roadtothewest/SSI/archivo/docs/refactor-emg-software.md

# Refactor de software a sEMG

**Estado:** especificación activa. Define la fuente sEMG de 4 canales en
todo el árbol de software del proyecto SSI (firmware, `ssr-ingest`, `export.py`,
arquitectura de modelo, HMI).

**Fecha:** septiembre 2026. Contexto: Muestra TECH 2026, 15 de octubre.

**Relación con otros documentos:**

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

---

## 0. Mantra del proyecto (principio rector)

Todo lo que sigue existe para cumplir **dos objetivos simultáneos, no uno**:

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

---

## 1. Decisiones ya cerradas (no reabrir)

| Decisión | Valor | Fuente |
|---|---|---|
| Sensor primario | sEMG diferencial, **4 canales** (submentoniano, platisma, labio inferior, laringe) + RLD | `AFE_EMG_Diseno.md` |
| AFE | Construcción propia (discreto, 4 canales), no comprar AFE comercial armado; HackEEG/ADS129x evaluados y descartados por no-disponibilidad (no por mérito técnico) | `AFE_EMG_Diseno.md` §1, §3-4; ver también §7.3 de este doc |
| Micrófono | **Digital I2S — INMP441**, candidato recomendado, **NO comprado aún** | `bom.csv`; investigación previa a la compra en §2 de este doc |
| Entrada auxiliar analógica de mic vía ADS129x | Descartada, no aplica (no se usa ADS129x) | Indicación explícita del usuario |
| Arquitectura de modelo (Conv2D paralelo por canal → TCN causal → vocoder WORLD) | Se mantiene sin cambios de topología | `sprints/sprint-1/DL.md`, `clave.md` — el pipeline es agnóstico al tipo de sensor, solo cambia la semántica de los 4 canales de entrada |

---

## 2. Micrófono digital: investigación previa a la compra

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

**Evidencia encontrada (calidad de audio real, no solo hoja de datos):**

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

---

## 3. Metodología de causalidad — esto define el éxito del proyecto

Esta es la sección más importante del refactor. Medir sEMG no vale nada si el
software solo reporta una correlación de Pearson. El argumento nuevo del proyecto es que el sEMG es
la **causa** (activación neuromuscular), anterior en el tiempo al sonido — y
esa anterioridad tiene que ser medible.

### 3.1 Lo que no basta

Un coeficiente de correlación entre sEMG y voz demuestra correlación, no
causalidad.

### 3.2 Lo que sí sostiene la afirmación

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

### 3.3 Confusor crítico: el canal laríngeo (CH4)

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

Controles obligatorios del protocolo de captura:

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

### 3.4 Protocolo de diagnóstico por canal (piso de ruido es una lectura, no el objetivo)

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

---

## 4. Esquema de datos y transporte

- **Requisito nuevo del esquema de tupla:** cada tupla del corpus debe llevar
  el lag medido (o los datos crudos suficientes para recalcularlo). Sin eso,
  el dataset solo sostiene correlación, no causalidad — es el mismo problema
  del punto 3.1 pero a nivel de formato de archivo, no de análisis.
- El frame EMG (tipo `0x03`, definido en `AFE_EMG_Diseno.md` §5.1) es la
  fuente de la CWT. El frame AUDIO (`0x02`, del INMP441) no cambia.
- El servicio Go (`ssr-ingest`) no debe caerse ante desconexiones del AFE.

---

## 5. Corrección de un supuesto del plan original: ventana vs. hop de la CWT

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

---

## 6. Checklist de refactor de software (archivo por archivo)

**Firmware (`ssr-testbed/firmware/`)**

- [x] Driver del sensor anterior eliminado (`main.c`, `frame.c`, `Makefile`,
      `usb_cdc.h`), 27-sep.
- [ ] `Core/Src/frame.c`: agregar `frame_process_emg_*`, leyendo 4 canales
      desde ADC+DMA, con `CDC_TYPE_EMG` (`0x03`). En `main.c` hay un
      comentario en el lazo principal donde va la llamada.
- [ ] Bug previo: `frame.c` usa `active_buf`, que es `static` en
      `inmp441.c` (no compila); y `inmp441.c` registra los callbacks de TX de
      I2S (`HAL_I2S_TxHalfCpltCallback`) en vez de los de RX.
- [ ] `Core/Src/sync_timer.c`: se reutiliza sin cambios (la base de tiempo
      común es agnóstica al sensor).

**PC — ingesta (`ssr-testbed/pc-tools/ssr-ingest/`, Go)**

- [x] Parser (`parser/frame.go`), `ssr-inspect` y `ssr-replay`: reconocen el
      frame `0x03` (27-sep).
- [ ] `storage/writer.go`: agregar el sensor EMG a `metadata.json` y su
      contador de frames. Además no compila por errores previos
      (`sha256.Sum256` usado como tipo, `WriteFrame` declarado dos veces).

**PC — exportación (`ssr-testbed/pc-tools/ssr-export/export.py`)**

- [x] `extract_emg_channels`: 4 canales int16 intercalados, timestamps con la
      tasa real del ADC (`--fs-emg`, 2 kHz por defecto); CWT de 20–500 Hz por
      canal, salida `cwt_mag` (4, escalas, N). Probado con un `.ssr`
      sintético (27-sep).
- [x] `align_channels`: alinea EMG y audio por timestamp.
- [ ] CWT: separar parámetro `window_ms` (≥50–100 ms) de `hop_ms` (5/10/20 ms)
      — ver §5 de este documento.
- [ ] Agregar el cálculo de correlación cruzada con lag (§3.2) como parte del
      pipeline de exportación, no como notebook aparte.

**Round-trip de audio (`ssr-testbed/pc-tools/ssr-roundtrip/`)**

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

**Documentación del testbed (`ssr-testbed/docs/`)**

- [x] `architecture.md`, `pinout.md`, `pipeline.md` y diagramas describen la
      fuente sEMG (27-sep). Los pines del ADC siguen **bloqueados por una
      decisión pendiente** — ver TODO 7.1 más abajo.

**Modelo (`sprints/sprint-1/DL.md`, `clave.md`)**

- [x] Adaptados a 4 canales sEMG (submentoniano, platisma, labio inferior,
      laringe): ramas Conv2D paralelas por canal y TCN causal (27-sep).

**HMI**

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

---

## 7. Preguntas abiertas (genuinas — no decidir por defecto)

### 7.1 MCU objetivo del testbed — **inconsistencia detectada, requiere decisión del usuario**

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

### 7.2 Resolución de ADC y ganancia total

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

### 7.3 Mínimo de canales para la demo — **CERRADO EN 4**

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

**No se vuelve a reabrir esta pregunta** salvo cambio de presupuesto o de
disponibilidad de componentes.

### 7.4 Tipo de inferencia del modelo

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

---

## 8. Especificación de HMI multi-pestaña

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

## 9. Verificación de bi-direccionalidad del vocoder WORLD

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

## 10. Referencias

- `docs/afe-emg/AFE_EMG_Diseno.md` — diseño de hardware del AFE sEMG (4 canales).
- [ESP32 Audio Input - INMP441 and SPH0645 MEMS I2S Breakout Boards (atomic14, YouTube)](https://www.youtube.com/watch?v=3g7l5bm7fZ8)
- [ICS-43434, a replacement for the old INMP441 (atomic14)](https://www.atomic14.com/videos/posts/VVGln_-XEgI)
- `bom.csv` — estado de compra de componentes (INMP441 candidato, pendiente de compra; AFE sEMG de 4 canales cotizado — ver §7.3).
- [BioAmp EXG Pill — Crowd Supply](https://www.crowdsupply.com/upside-down-labs/bioamp-exg-pill) — pricing consultado sep. 2026: USD 35–249 según pack, sin RLD onboard.
- [HackEEG — Crowd Supply](https://www.crowdsupply.com/starcat/hackeeg) — USD 495–2090, descontinuado (sin stock) al consultar sep. 2026.
- `ssr-testbed/pc-tools/ssr-roundtrip/` — prototipo de round-trip de audio (Mel+Griffin-Lim, pendiente extender a WORLD — ver §9).
- `sprints/sprint-1/clave.md` — comparación Mel+Griffin-Lim vs. vocoder WORLD, recomienda WORLD.
