roadtothewest/SSI/archivo/sprints/sprint-1/gpt-ups-pelao.md

Puedes lograr un diseño compacto usando componentes miniaturizados.
## Alternativas de tamaño reducido

* La Batería (UPS): En lugar de celdas cilíndricas 18650, usa una batería de Polímero de Litio (LiPo) plana. Una de 1000 mAh a 2000 mAh tiene el grosor de un teléfono móvil y se puede colocar directamente debajo de la Radxa.
* La Placa de Control (UPS): Existen módulos de carga y elevación de voltaje (como el chip IP5306 o similares) en circuitos de apenas 2 cm × 2 cm que entregan 5V/2A o 3A con soporte "pass-through".
* El Parlante: Los parlantes piezoeléctricos o los altavoces de tipo "móvil/laptop" (de 1W o 2W) miden pocos milímetros de grosor y consumen muy poca corriente.

Si apilas la batería LiPo, la Radxa y la pequeña placa UPS, el grosor total del dispositivo podría ser menor a 2.5 centímetros, manteniendo la misma superficie pequeña de la Radxa Zero (6.5 cm × 3 cm).
Para ayudarte a optimizar el espacio, cuéntame:

* ¿Cuánto tiempo de autonomía de batería necesitas que tenga el dispositivo sin estar enchufado?
* ¿El parlante es para reproducir alertas/pitidos cortos o para reproducir voz/música continua?
