roadtothewest/SSI/docs/afe-emg/BoM_AFE_AuraVox_compacta.pdf

BoM compacta AFE sEMG AuraVox (3 canales, incluye repuesto). Detalle por modulo en BoM_AFE_AuraVox.xlsx

Valor / parte | Cantidad | Componente
SOIC8 a DIP8 | 7 Adaptador SOIC-8 a DIP-8
SOT23 a DIP | 2 Adaptador SOT-23-5 a DIP
Alcohol isopropilico / gel | 1 Alcohol isopropilico / gel
jumper Dupont | 3 Cable 5 V y GND desde el DK
jumper Dupont | 5 Cable a Arduino A1..A3 del STM32N6570-DK
broche 4 mm a pin | 8 Cable de electrodo con broche (snap) 4 mm, idealmente apantal
24 AWG rigido | 1 Cable para puentes
jumper Dupont | 6 Cables Dupont para el microfono
header 2.54 mm 1x8 + hembra | 2 Conector en la placa para los 7 cables
3M Red Dot 2228/2560 | 50 Electrodo Ag/AgCl con broche
INA333 modulo MCU-333 | 4 INA333 (modulo MCU-333)
INMP441 | 2 Modulo microfono digital INMP441 (I2S)
TS922AIYDT | 6 Op-amp doble TS922AIYDT (Global 001-TS922)
10 x 15 cm | 2 Perfboard
TLV75733PDBVR | 2 Regulador LDO 3.3 V TLV75733PDBVR (Global 014-75733)
2.54 mm | 3 Tira de headers macho/hembra
DIP-8 | 7 Zocalo DIP-8
100p | 4 cond. ceramico C0G
1n | 10 cond. ceramico C0G
47p | 8 cond. ceramico C0G
100n | 12 cond. ceramico/electrolitico
10u | 7 cond. ceramico/electrolitico
1u | 3 cond. ceramico/electrolitico
100n | 8 cond. poliester (film)
150n | 4 cond. poliester o C0G
15n | 4 cond. poliester o C0G
2.2n | 4 cond. poliester o C0G
1N4148 | 16 diodo
100 | 4 resistencia
100k | 10 resistencia
10M | 2 resistencia
110k | 4 resistencia
1k | 8 resistencia
2.2k | 4 resistencia
2.4k | 4 resistencia
2.7k | 10 resistencia
300k | 4 resistencia
390k | 2 resistencia
56k | 12 resistencia
620k | 4 resistencia

Precio unit. (CLP) | Subtotal (CLP) | Comprado
TOTAL | -
