roadtothewest/SSI/archivo/sprints/sprint-1/clave.md

El uso de la NPU de la STM32N6 cambia las reglas del juego a tu favor, ya que te permite manejar un volumen de operaciones mucho mayor, pero las restricciones de memoria y operadores soportados son estrictas.
Aquí tienes cómo resolver los cuellos de botella de la NPU y la mejor alternativa matemática para tu algoritmo bi-direccional.
Resolviendo las restricciones de la NPU (STM32N6)
BatchNormalization (El truco del "Folding"): No te preocupes por la falta de soporte para BN en la NPU. Durante la conversión del modelo (cuando pasas de TensorFlow/ONNX a C mediante X-CUBE-AI), el compilador aplica una optimización estándar llamada Conv-BN Folding. La matemática de la normalización (medias y varianzas) se absorbe permanentemente en los pesos y sesgos de la capa Conv1D/Conv2D anterior. En tiempo de ejecución, la capa de Batch Normalization literalmente no existe; la NPU solo ejecuta la convolución modificada.
Cero Transpose: Para evitar operaciones de transposición de tensores, tu modelo debe mantener una estructura estricta de Channels-Last (Batch, Time, Features). El peligro de generar un Transpose oculto ocurre al pasar de la etapa 1 (CNN 2D) a la etapa 2 (TCN 1D). Para evitarlo, no uses capas que permuten dimensiones; usa un simple Reshape que fusione el eje de canales y el eje de frecuencias de la CWT, manteniendo el eje temporal exactamente en la misma posición geométrica en la memoria.
Activaciones de salida en CPU: Tienes toda la razón. Si Sigmoid o Tanh no están soportadas por la NPU, forzarán una ruptura del grafo (CPU fallback). La solución para mantener 0 SW layers es dejar la última capa Densa con activación Linear (es decir, sin función de activación). La NPU entregará las predicciones numéricas crudas, y tú aplicas el recorte o normalización matemáticamente en tu código C en el procesador principal de la STM32N6 antes de enviarlo al algoritmo generador de voz.
El Algoritmo Determinista Bi-direccional
Para que tu sistema sea viable, necesitas extraer "tokens" (vectores de características) del audio real para entrenar el modelo, y luego usar esos mismos vectores (ahora predichos por tu modelo desde las señales sEMG) para generar voz.
Dado que tu objetivo es voz humana para personas afónicas y exiges un algoritmo determinista (descartando vocoders neuronales pesados como HiFi-GAN que requieren otra red neuronal), tienes dos caminos principales.
El claro ganador para fidelidad de voz es el Vocoder WORLD.


Característica
Mel-Spectrogram + Griffin-Lim
Vocoder WORLD (o STRAIGHT)
Bi-direccionalidad
Alta (STFT de ida, Griffin-Lim de vuelta)
Perfecta (Análisis y Síntesis paramétrica)
Naturaleza de los "Tokens"
Bandas de energía espectral (ej. 80 coeficientes Mel)
$F_0$ (Pitch), Envolvente Espectral (Formantes), y Aperiodicidad
Fidelidad de la Voz
Robótica/Metálica (por los errores de estimación de fase)
Alta (Conserva la identidad vocal y la naturalidad del habla)
Determinista
Sí (Matemática pura)
Sí (Matemática pura)
Carga Computacional (Síntesis)
Media
Media-Alta (Ideal para la PC/Raspberry que mencionaste)
¿Por qué WORLD es el estándar para esto?
WORLD funciona separando la voz en sus componentes físicos fundamentales:
Análisis (Creación del Dataset): Pasas tus grabaciones de micrófono por WORLD. El algoritmo extrae el $F_0$ (la vibración de las cuerdas vocales), la Envolvente Espectral (cómo se posiciona la boca/lengua) y la Aperiodicidad (ruido/aire). Estos arreglos numéricos son los "tokens" o targets que tu modelo aprenderá a predecir.
Síntesis (Inferencia en vivo): Tu STM32N6 escupe estos tres arreglos predichos y los envía a la Raspberry o PC. El sintetizador de WORLD toma estos parámetros y los combina matemáticamente usando filtros digitales para generar el archivo .wav de salida.
%%%%%%%%%%%%%%%
El desarrollo de una interfaz de habla silenciosa (Silent Speech Interface) basada en sEMG es un excelente caso de uso para Edge AI. Inferir parámetros acústicos a partir de la actividad eléctrica de los músculos del habla requiere un modelo capaz de extraer tanto patrones frecuenciales instantáneos como dependencias temporales largas.
Para garantizar que el modelo final se despliegue en tu STM32 con 0 capas de software (sin CPU fallbacks), la clave es construir toda la arquitectura utilizando exclusivamente operadores matemáticos estándar soportados nativamente por optimizadores como X-CUBE-AI (por ejemplo, convoluciones, activaciones estándar, pooling y capas densas).
Aquí tienes una recomendación de arquitectura optimizada para este flujo:
Etapa 1: Extracción de Características (CNN en paralelo)
Dado que tu entrada es un espectrograma generado por la CWT (Tiempo $\times$ Escalas $\times$ 4 canales sEMG), esta etapa debe tratar la entrada casi como una imagen, pero respetando el eje temporal.
Arquitectura recomendada: Bloques de Depthwise Separable Convolutions (Conv2D).
Diseño: Divide la entrada en sub-ventanas temporales. En lugar de usar convoluciones 2D estándar (que consumen mucha memoria y ciclos de reloj), usa convoluciones separables. Esto aplica un filtro por cada canal (canal sEMG) y luego combina los resultados.
Paralelismo: Puedes tener cuatro ramas de CNN paralelas, una por canal sEMG (submentoniano, platisma, labio inferior, laringe), para extraer la firma de cada músculo de forma independiente, concatenando los mapas de características al final de esta etapa.
Compatibilidad: X-CUBE-AI soporta DepthwiseConv2D y SeparableConv2D de forma muy eficiente, acelerando el proceso mediante las instrucciones DSP del microcontrolador.
Etapa 2: Modelado Temporal (TCN)
Una Temporal Convolutional Network (TCN) es la elección perfecta para Edge AI, superando a las redes recurrentes (como LSTM o GRU). Las TCNs no tienen estados ocultos que mantener en memoria, se paralelizan mejor en inferencia y evitan operaciones no estándar.
Arquitectura recomendada: Capas de Dilated 1D Convolutions.
Diseño: La salida de la Etapa 1 se aplana en el eje de las frecuencias/escalas, quedando como un tensor de (Tiempo $\times$ Características). Pasas esto por una serie de Conv1D causales con factores de dilatación exponenciales ($d = 1, 2, 4, 8$).
Ventaja: Esto le da al modelo un "campo receptivo" muy amplio (necesario para entender fonemas largos o palabras enteras) sin aumentar la profundidad de la red a niveles incompatibles con la RAM del microcontrolador.
Compatibilidad: Para mantener los 0 SW layers, asegúrate de implementar la TCN utilizando estrictamente Conv1D estándar y BatchNormalization. Evita usar implementaciones de TCN de terceros que incluyan operaciones personalizadas de padding o slicing que el generador de código de la STM32 no reconozca.
Etapa 3: Proyección Acústica (Regresión)
Esta es la etapa de salida que conecta el modelo temporal con tu algoritmo determinista (Vocoder).
Arquitectura recomendada: Capas Densas (Fully Connected) o una Conv1D de tamaño de kernel 1.
Diseño: Esta etapa mapea la representación abstracta del TCN a los parámetros acústicos exactos que necesita tu sintetizador. Si usas un vocoder clásico (como WORLD o LPC), el modelo no debe generar el audio directamente, sino predecir los parámetros (Frecuencia fundamental $F_0$, envolvente espectral, aperiodicidad).
Función de activación: Linear o Sigmoid/Tanh dependiendo de cómo normalices los parámetros del vocoder.
Recomendaciones críticas para el Dataset y el Hardware
Sincronización de reloj (El mayor desafío): Al parear los datos RAW del ADC sEMG y el audio RAW del micrófono, la sincronización es vital. Los relojes del micrófono (I2S) y del muestreo del ADC derivarán ligeramente. Utiliza interrupciones de hardware en la STM32 (por ejemplo, la de fin de transferencia DMA del ADC) acopladas a marcas de tiempo (timestamps) de alta precisión para etiquetar tanto el audio como el sEMG.
CWT en el Microcontrolador vs PC: Calcular la CWT en el micro durante la recolección es una gran idea para probar el rendimiento, pero guarda también los datos RAW del sEMG en tu dataset. Las matemáticas de punto flotante de la librería CWT en la STM32 (Float32 o Fixed-Point) tendrán ligeras diferencias con la CWT calculada en Python. Durante el entrenamiento, necesitarás simular el ruido y la pérdida de precisión exacta que genera el cálculo en el micro.
Restricciones de activación: Para garantizar que el grafo de TensorFlow/Keras se traduzca limpiamente a C, usa exclusivamente activaciones ReLU. Funciona perfectamente para procesamiento de voz y está altamente optimizada en CMSIS-NN.

----

https://huggingface.co/spaces/STMicroelectronics/stm32-modelzoo-app

https://huggingface.co/STMicroelectronics/models

https://github.com/STMicroelectronics/stm32ai-modelzoo-services

https://github.com/STMicroelectronics/stm32ai-modelzoo/tree/main/speech_enhancement/stft_tcnn
