roadtothewest/SSI/archivo/sprints/sprint-1/DL.md

Estás muy cerca de la arquitectura ideal, pero la lógica estructural tiene un detalle crucial con respecto a la dimensionalidad de tu entrada.

La secuencia de **"Extracción paralela $\rightarrow$ Modelado Temporal"** es el enfoque correcto, pero en tu primera etapa **no deberías usar Conv1D, sino Conv2D**.

Al procesar los datos a través de una Transformada Wavelet Continua (CWT), cada señal sEMG unidimensional se convierte en un mapa bidimensional (un escalograma). Dado que tu pipeline extrae 64 escalas logarítmicas (de 20 a 500 Hz, la banda del AFE), tu red neuronal debe tratar esta entrada como si fuera una "imagen" para poder reconocer patrones geométricos en las frecuencias.

Aquí tienes la topología exacta de cómo deben fluir los tensores a través de la NPU de tu STM32N6:

### Etapa 1: Extracción Espacial en Paralelo (Conv2D)

En lugar de procesar los 4 canales sEMG mezclados desde el inicio, usar ramas paralelas permite que la red aprenda la firma mioeléctrica independiente de cada músculo.

1. **Entrada:** Cuatro tensores separados, uno por canal sEMG. Cada tensor tiene una forma dimensional de $T \times 64 \times 1$ (donde $T$ son los pasos de tiempo de tu ventana y 64 son las escalas de la CWT).

2. **Ramas Paralelas (Conv2D):** Cada canal pasa por su propia torre de convoluciones 2D.
* *Tip de Hardware:* Para no desbordar la SRAM de la STM32N6, utiliza *Depthwise Separable Convolutions 2D*. Estas extraen patrones de texturas frecuenciales y reducen los requerimientos computacionales drásticamente.

3. **Fusión (Concatenación):** Al final de las torres 2D, concatenas los mapas de características resultantes de los 4 canales en un solo tensor.

### Etapa 2: El "Pegamento" (Reshape)

Para conectar el mundo de las imágenes (Conv2D) con el mundo de las series de tiempo (TCN), necesitas transformar la dimensionalidad.

* **Operación:** Colapsas (aplanan) el eje de las frecuencias resultantes y el eje de los canales, preservando estrictamente el eje temporal.
* **Resultado:** Pasas de un tensor tridimensional a uno bidimensional: $T \times \text{Características}$. Este vector ya no representa frecuencias aisladas, sino un "resumen abstracto" de la actividad muscular en cada instante $T$.

### Etapa 3: Modelado Temporal (TCN con Conv1D)

Aquí es donde entran las **Conv1D**. Ahora que tienes un vector de características sólido para cada instante de tiempo, la Temporal Convolutional Network (TCN) se encarga de entender el contexto a largo plazo (cómo la activación muscular de hace 15 milisegundos afecta el sonido actual).

* **Bloques Causales:** Utilizarás capas **Conv1D** con *dilataciones causales* (donde el factor de dilatación aumenta exponencialmente, ej. $d = 1, 2, 4, 8$). Esto permite que la red tenga un "campo receptivo" altísimo, observando toda la ventana de tiempo simultáneamente sin necesidad de recurrencia.
* **Salida (Regresión):** La última capa será una Densa (Totalmente Conectada) con activación lineal que mapeará estas características temporales hacia los valores exactos (tokens) que necesita tu vocoder WORLD ($F_0$, Envolvente Espectral, y Aperiodicidad).

---

Considerando que aplicarás convoluciones bidimensionales sobre 64 escalas logarítmicas, ¿has definido qué factor de dilatación máximo ($d=2, 4, 8, 16...$) planeas usar en las capas Conv1D de la TCN para cubrir el campo receptivo de un fonema completo sin sobrepasar el límite de memoria estática de la NPU?
