roadtothewest/SSI/docs/AuraVox.pdf

## AuraVox

Estacion de Auditor ´ | ía – Corpus Generator

Matías Perez, Vicente Andrade ´

| Septiembre 2026

## 1. Arquitectura

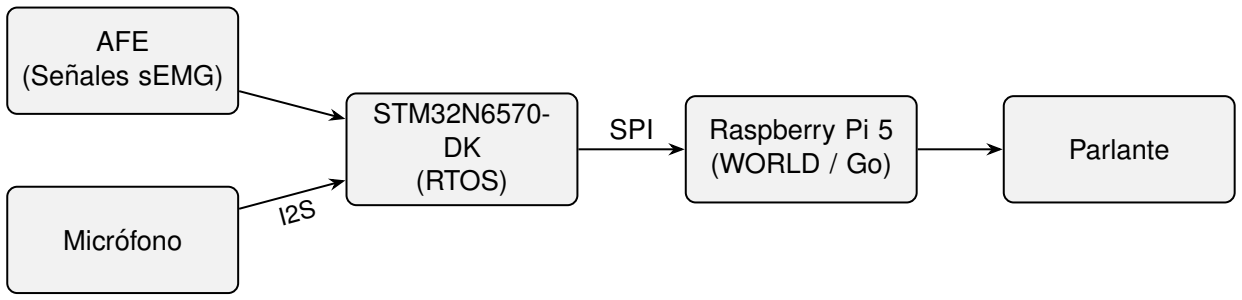
[picture p1: figure]
AFE (Senales sEMG) ˜; Microfono ´; STM32N6570- DK (RTOS); Raspberry Pi 5; (WORLD / Go); Parlante; SPI

## 2. Objetivos Específicos

Obtener correlacion y causalidad voz ´ | | ↔ sEMG: Demostrar la causalidad empírica-
mente: de la energía espectral neuromuscular pura hacia los fonemas.

Medir ”Piso Ruido” (baseline del stream espectral que alimenta al pipeline):

- Condiciones de evaluacion: AFE apagado, AFE encendido, y usuario callado. ´
- Caracterizar lecturas y diferenciar el stream sEMG con voz versus el stream con silencio.
- Resolver: ¿Es puro ruido o contiene informacion´ util para el modelo? ´

HMI: Monitoreo Benchmark de Procesamiento:

- Definir metricas y gr ´ | aficos para validar el proceso de causalidad. ´
- Comparar el calculo de ventanas CWT ( ´ | | cwt-win) entre la N6 y la Raspberry Pi.
- Probar barridos de ventanas de distinta duracion (5ms, 10ms, 20ms, etc.). ´
- Extraccion de features del Micr ´ | ofono: Envolvente, ´ | F0, Paratemporalidad, Magnitud y
Tono.

Orquestacion del Minimum Viable Dataset: ´

- Ingesta de paquetes: AFE → Microfono ´ → Time Stamp → Miscelaneos (ventanas ´ CWT, etc.).
- Conformacion del Dataset: Tuplas CWT-Vector (con correlaci ´ | | on real demostrada). ´

## 3. Plan de Ataque: El Sprint de 30 Días

Dado que tienes exactamente un mes, la clave para ganar no es implementar mas carac- ´ terísticas, sino pulir la narrativa visual y la robustez de la prueba de concepto.

La Estacion ”Benchmark” debe verse intencional: ´ | Mencionaste que los electrodos
deben tener una distancia relativa constante (platisma, triangulo submentoniano, etc.). ´
Para la muestra, no uses cables sueltos con cinta. Si puedes, disena un arn ˜ | es impreso en ´
3D (con filamento flexible tipo TPU) o un soporte de silicona que mantenga la geometría de los 8 canales fija. Esto grita ”rigurosidad científica” y demuestra que tu dataset será confiable.

El Cliente Web es tu ”Showstopper”: El jurado no puede ver el codigo en RTOS ni los ´ paquetes SPI, pero sí pueden ver una interfaz web. Dedica tiempo a que el dashboard de
Golang muestre la senal de voz del I2S arriba, y las se ˜ | nales sEMG abajo en tiempo real. ˜
Cuando audites la causalidad, muestra un índice de correlacion visual (un porcentaje o ´ un mapa de calor) que reaccione instantaneamente al movimiento muscular. ´

El Discurso del ”Vector de Apoyo”: En tu pitch, explica claramente que no estas sinte- ´
tizando la voz final todavía, sino demostrando que la senal sEMG contiene la informaci ˜ | on´
causal suficiente (el vector de apoyo) para regenerarla. El software de la Pi corriendo el
algoritmo WORLD es la demostracion matem ´ | atica de que si el hardware captura bien, la ´
síntesis humana es posible.

Si sobra tiempo (CubeAIStudio): Solo si tienes el hardware y el cliente web funcionando al 100 % en la semana 3, intenta correr un modelo miniatura en CubeAIStudio. Si no, no lo
fuerces. Una estacion de captura perfecta y robusta con gr ´ | aficas en tiempo real punt ´ | uá
mas alto (en Nivel T ´ | ecnico y Presentaci ´ | on) que un modelo de IA a medias que hace ´
colapsar el sistema.

## Anexo A: Tareas Particulares (Tasks)

Comprar AFE.

Montaje: Disenar e implementar la bater ˜ | ía y hacer la estacion portable (RPi5 + N6 + AFE ´
+ Mic).

Revisar sleep modes de los componentes.

Validar capturas, pipeline AuraVox completo, HMI y la metrica de Pearson DNN-tuple. ´

Determinar el Minimum Viable Dataset y que tipo de inferencias-modelo se ajustan mejor ´ (¿continuous speech?, etc.).

Construir y validar Demo v0.1 de Inferencia Edge.

## Anexo B: Evaluacion frente a la R úbrica y Estrategia ´

AuraVox es un proyecto con un nivel de madurez arquitectonica y conceptual alt ´ | ísimo. Es
inteligente, porque en lugar de intentar forzar un producto final inalcanzable en 30 días, estas´
pivotando hacia la creacion de la infraestructura fundacional: una estaci ´ | on de auditor ´ | ía y ge-
neracion de datasets de calidad m ´ | edica. Eso demuestra un entendimiento profundo del ciclo ´
de vida del Machine Learning aplicado al hardware.

La eleccion de la arquitectura del STM32 N6 es un gran acierto estrat ´ | egico para este tipo ´
de modelo de procesamiento de datos en entornos competitivos; su capacidad de DSP nativa para las ventanas CWT y su NPU preparan el terreno perfectamente para la futura red feedforward y la inferencia embebida que buscas en produccion. ´
Aquí tienes un analisis de c ´ | omo tu MVP de 30 d ´ | ías encaja en la rubrica y d ´ | onde debes ´
concentrar el esfuerzo para asegurar la mayor puntuacion. ´
Criterio (Peso) | Analisis de AuraVox | Estrategia para Maximizar Pun- ´
| | tos

Creatividad
(40 %)

Excelente. El uso de sEMG para síntesis de voz en pacientes laringectomizados es de vanguardia (Silent Speech Interfaces). El enfoque de ”vender el software/auditor” en lugar de un prototipo a medias es innovador.

Enfatiza que la verdadera innova-
cion de esta etapa es la resoluci ´ | on´
del problema de los datos. Un modelo no sirve sin un corpus perfecto; tu estacion resuelve ese cuello de ´ botella de forma ingeniosa y portatil. ´

Nivel Tecnico ´
(25 %)

Sobresaliente. Arquitectura distribuida (STM32 + Pi 5), buses SPI/I2S, RTOS, AFE diferencial, Golang, y algoritmos de vocoder (WORLD). El desafío tecnico es ´ enorme.

La estabilidad lo es todo. Si la comunicacion SPI falla durante la de- ´ mo, pierdes puntos. Congela el firmware pronto y asegurate de que el ´ cliente Web en Golang no se caiga ante desconexiones del AFE.

Presentacion´
(20 %)

Zona de Riesgo. El proyecto es increíblemente complejo. Si el jurado no esta compuesto por ingenie- ´ ros embebidos, se perderan entre ´ ”RTOS”, ”CWT” y ”WORLD”.

Necesitas un puente visual. El cliente Web en la Pi no es solo para auditar, es tu herramienta de venta.
Las graficas de correlaci ´ | on deben ´
ser hipnoticas y f ´ | aciles de entender ´
para un lego.

Impacto (15 %) Muy Alto. Devuelve la voz a quienes la perdieron. Ademas, al enfocarte ´ en el software y la creacion del cor- ´ pus, demuestras que el proyecto es altamente escalable.

Habla del modelo de negocio (”vendemos Software”) y como esta ´ estacion portable permite levantar ´ el corpus masivo y diverso (IMC, edad, sexo) necesario para escalar a produccion. ´
