roadtothewest/SSI/Accel_Connections.png

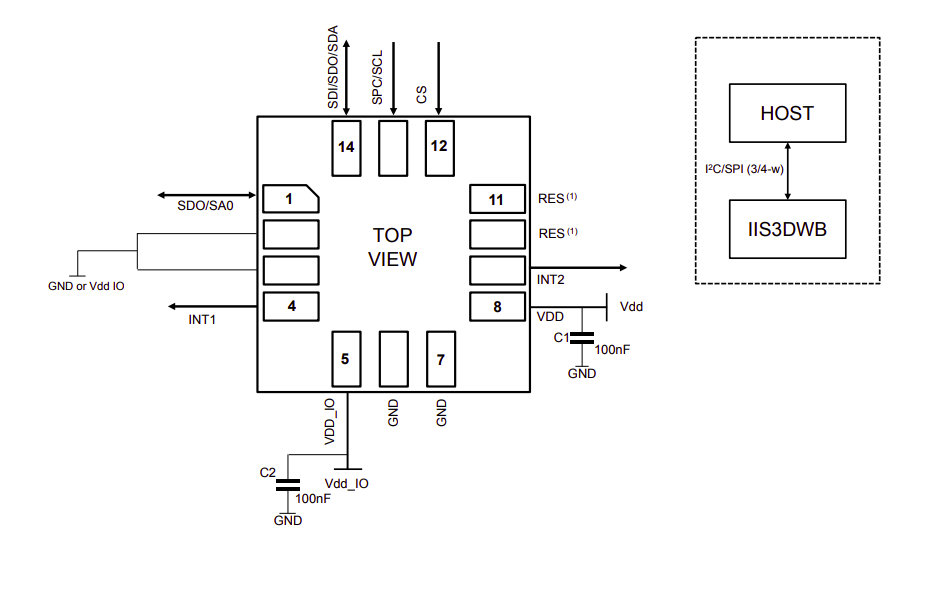
Accel_Connections.png
