roadtothewest/SSI/archivo/BIOAMP1.png

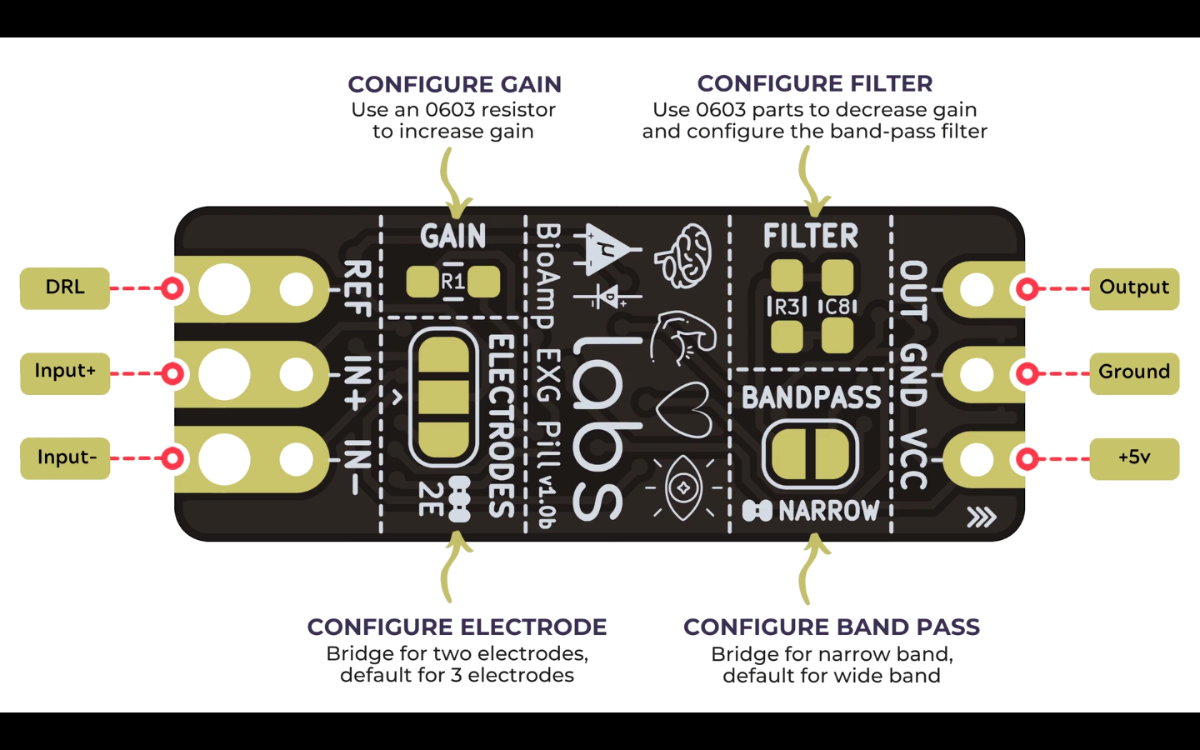
archivo/BIOAMP1.png
