roadtothewest/SSI/archivo/docs/afe-emg/figs/audit_rld_robustez.png

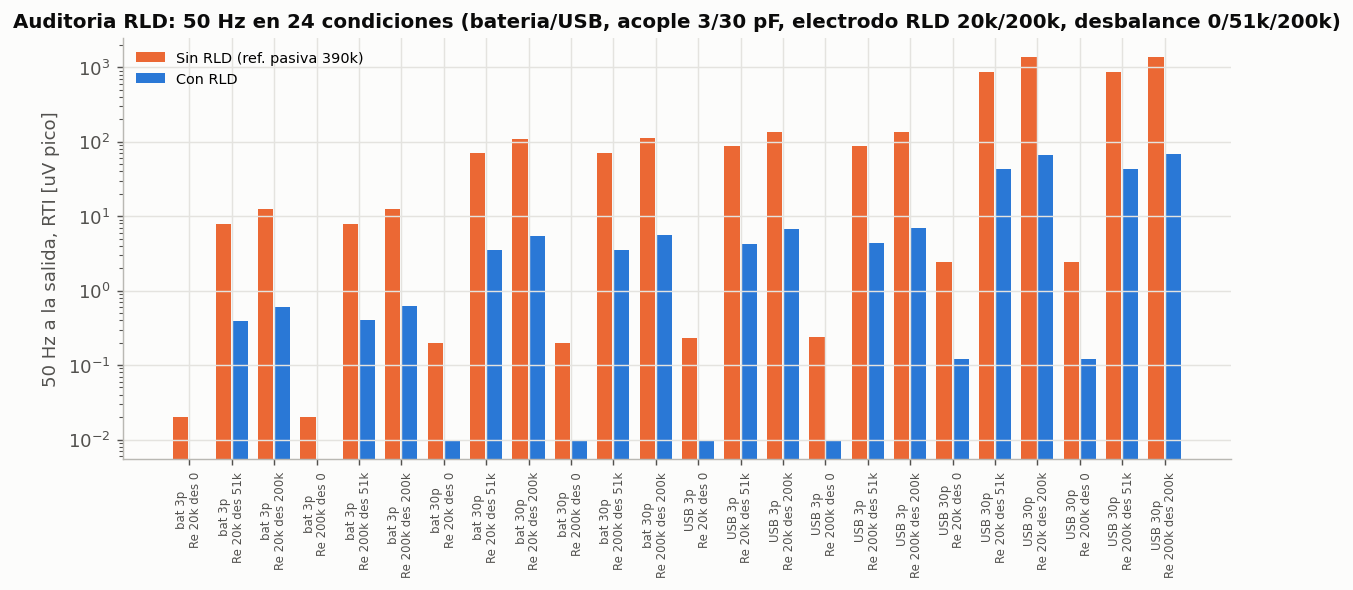
archivo/docs/afe-emg/figs/audit_rld_robustez.png
