roadtothewest/SSI/archivo/docs/afe-emg/figs/audit_semg.png

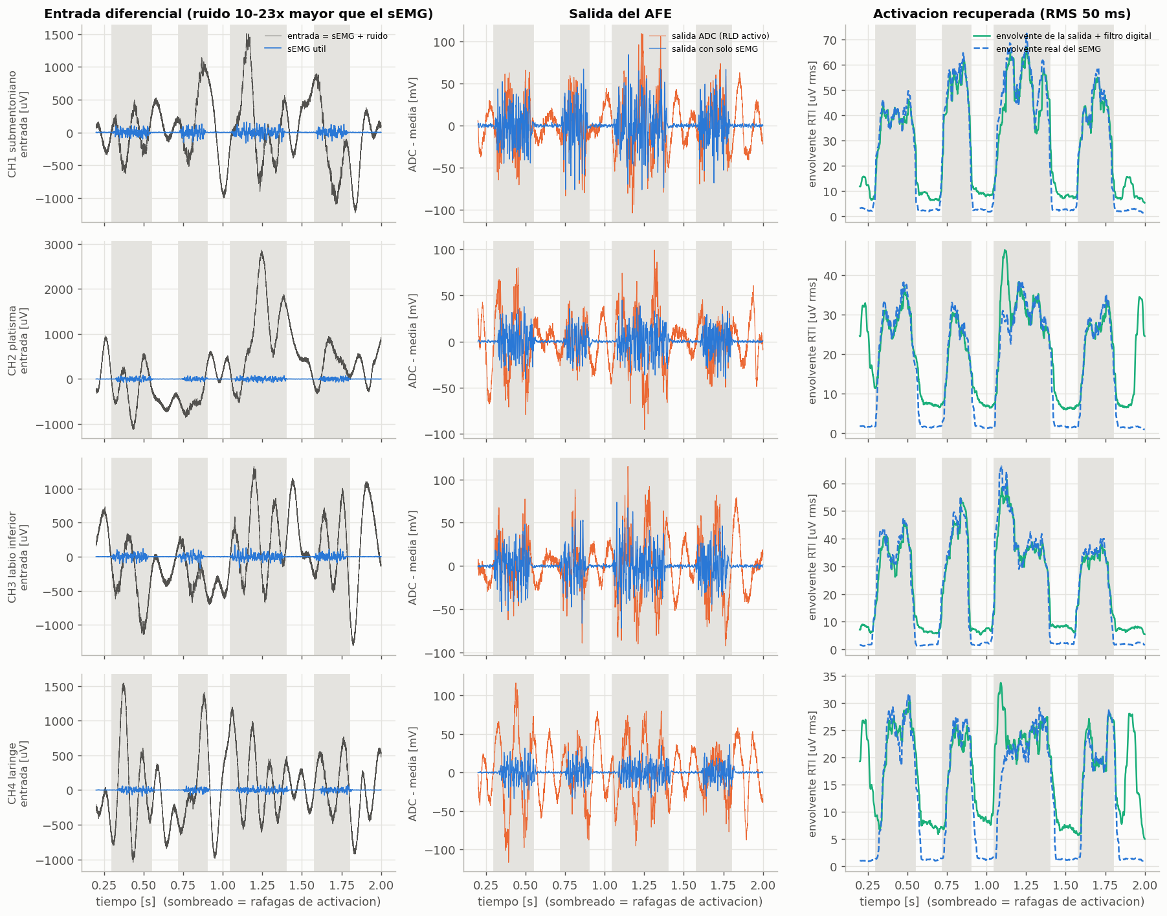
archivo/docs/afe-emg/figs/audit_semg.png
