roadtothewest/SSI/BIOAMP.png

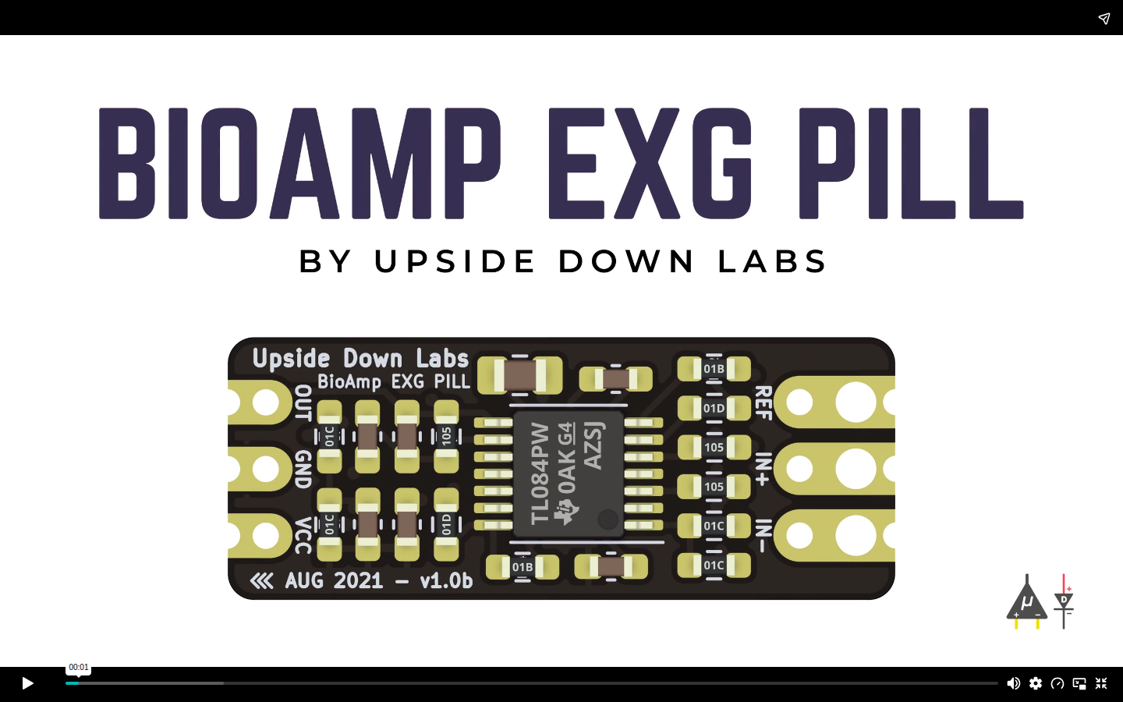
BIOAMP.png
