roadtothewest/SSI/docs/afe-emg/figs/t7_tiempo_ch1.png

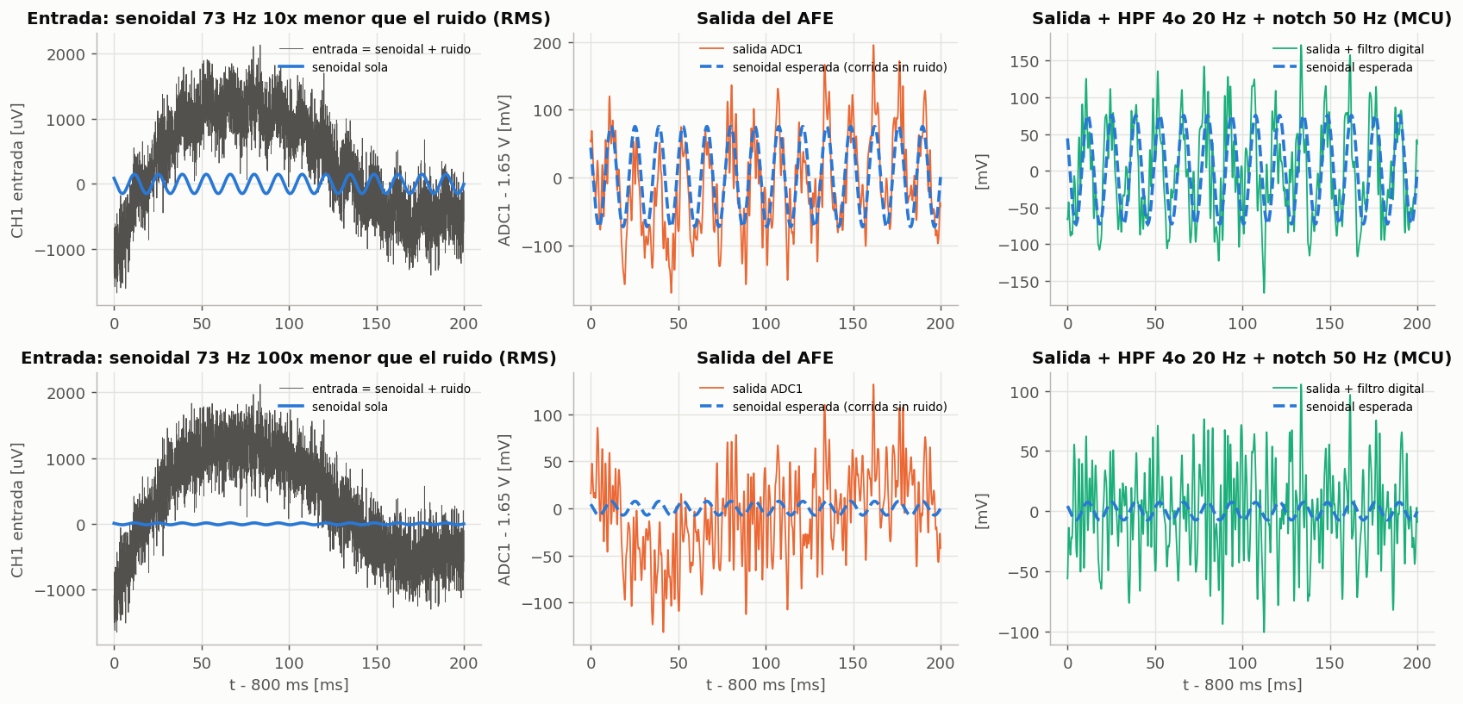
docs/afe-emg/figs/t7_tiempo_ch1.png
