roadtothewest/SSI/ssr-testbed/bom/suppliers.md

# Proveedores

## Electrónicos (Recomendados)

| Proveedor | Web | Ideal para |
|---|---|---|
| Mouser | mouser.com | Componentes STM, ST, TI, Murata. Envío rápido (~3-5 días) |
| Digikey | digikey.com | Similar a Mouser, buena disponibilidad de conectores JST |
| LCSC | lcsc.com | Pasivos, conectores, más barato pero China (~2 semanas) |
| AliExpress | aliexpress.com | Breakout boards baratos (INMP441), cables dupont |

## Adhesivos Médicos

| Producto | Proveedor | Web |
|---|---|---|
| 3M 1526L | 3M Medical | 3m.com/medical |
| | Amazon | amazon.com (búsqueda 3M 1526L) |
| | McMaster-Carr | mcmaster.com |
| Micropore 1530| Farmacias | Venta sin receta en cualquier farmacia |

## Mecánicos / Herramientas

| Ítem | Proveedor | Notas |
|---|---|---|
| Powerbank | Local / Amazon | Cualquier marca, 5V 2A mínimo |
| Protoboard | Local / AliExp | 400 puntos, medio tamaño |
| Analizador lógico | AliExpress  | Buscar "24MHz 8ch logic analyzer", ~$10 con puntas |
| Soldador | Local / Amazon | TS101 / Pinecil / Hakko FX-888D |
| Pinzas | Local / Amazon | Pinzas antiestáticas para 0402 |
