roadtothewest/SSI/bom.csv

 | Cantidad | Componente | Especificacion | Notas | Valor
x | 2 | Capacitor 100nF | SMD 0402 - Ceramico X7R | EN STOCK - desacople de los MCP6004/INA333 del AFE sEMG | 2600 (100u) | https://es.aliexpress.com/item/1005012749612838.html?curPageLogUid=UwTlK6NE4aYf
x | 1 | Regulador LDO 3.0V | SMD SOT-23-5 | EN STOCK - OJO: es de 3.0V y NO sirve como riel 3.3V del AFE (comprar LDO 3.3V de bajo ruido o correr el AFE a 3.0V) | 2700 (10u) | https://es.aliexpress.com/item/1005008622099084.html?curPageLogUid=Mux9l1uXvFZA
x | 2 | Capacitor 1uF | SMD 0402 - Ceramico X7R o X5R | EN STOCK - filtro IN/OUT del LDO del AFE sEMG | 1200(50u) | https://es.aliexpress.com/item/1005007464553853.html?curPageLogUid=jGMwvwQPEZJ2
 | 1 | Modulo Microfono INMP441 | Breakout Circular | NO COMPRADO - candidato recomendado (digital I2S) - pendiente de confirmar escuchando las muestras de audio real del video comparativo antes de comprar (ver docs/refactor-emg-software.md) | 1000 | https://es.aliexpress.com/item/1005012377065358.html?mp=1
 | 1 | Cables Dupont | Pines estandar | Para rutear el modulo INMP441 a la STM32
 |  | AFE sEMG (4 canales + RLD) - REABIERTO a 4 canales sep. 2026 - tope USD 60 ajustado (ver docs/afe-emg/AFE_EMG_Diseno.md #1 y docs/refactor-emg-software.md #7.3; HackEEG/ADS129x evaluado y descartado por no-disponibilidad - ver docs)
 | 4 | INA333AIDGKR | VSSOP-8 + adaptador MSOP8->DIP8 | INA por canal (decision del usuario 26-sep) - G1=20.16 con RG partido 2x2.61k 0.1% (punto medio -> RLD); comprar en distribuidor autorizado y validar ganancia en banco - ver docs/afe-emg/AFE_valores_ltspice.md | cotizar
 | 6 | MCP6004-I/P (cuadruple) | PDIP-14 | 22 op-amps: 5 por canal (HPF + G2 + LPF x2 + buffer) x4 + RLD + seguidor VREF (2 libres) - rail-to-rail 1.8-6V 1MHz - ver AFE_valores_ltspice.md #1.2 | cotizar
 |  | Resistencias 1% y capacitores C0G/film | Lista completa en AFE_valores_ltspice.md #4 | ~74 R + ~60 C; HPF 100nF en film; RG 0.1%; simulado en sim/ltspice | 6500-12000 (estimado)
 |  | Protoboard/perfboard + cables + headers | Ruta B (through-hole - sin PCB fabricado) | Sin dependencia de envio de manufactura - ver AFE_EMG_Diseno.md ruta B | 4500-9500 (estimado)
 | 9 | Electrodos Ag/AgCl - preferir reusables sobre pregelados desechables | Desechables o reusables | 4 sitios bipolares (8) + 1 referencia/RLD - reusables bajan este item si el costo total se acerca al tope | 5500-9500 (estimado)
 | 1 | Gel/prep de piel (Nuprep + alcohol) |  | Preparacion de contacto para reducir ruido de electrodo
 |  | Componentes AFE sEMG 4 canales (estimado - riesgo de acercarse/pasar tope USD 60): | 36000-65000 CLP aprox (~USD 38-68)
 |  | PCBs+Conectores | 0 (Ruta B: sin PCB fabricado)
 |  | Adhesivos | ?
