roadtothewest/SSI/docs/afe-emg/BoM_AFE_AuraVox_compacta.xlsx

BoM compacta AFE sEMG AuraVox (3 canales, incluye repuesto). Detalle por modulo en BoM_AFE_AuraVox.xlsx
Carritos del 4-oct-2026 cargados. Precios con IVA, sin despacho. En rojo: falta en los carritos.
Valor / parte | Cantidad | Componente | Tienda | En carrito | Precio unit. (CLP) | Subtotal (CLP) | Estado
S08D8 | 7 | Adaptador SOIC-8 a DIP-8 (S08D8, Global; trae PCB y 2 headers de 4) | Global Electronica | 12 | $250 | $3000 | Comprado
Alcohol isopropilico / gel | 1 | Alcohol isopropilico / gel |  |  |  |  | Pendiente
jumper Dupont M-M | 8 | Bus de 8 cables Dupont macho (separado de una tira de 40) | Global Electronica | 42 | $50 | $2100 | Comprado
jumper Dupont M-H | 3 | Cable 5 V y GND desde el DK |  |  |  |  | Pendiente
jumper Dupont M-H | 5 | Cable a Arduino A1..A3 del STM32N6570-DK | Global Electronica | 42 | $50 | $2100 | Comprado
broche 4 mm a pin | 8 | Cable de electrodo con broche (snap) 4 mm, idealmente apantallado |  |  |  |  | Pendiente
24 AWG rigido | 1 | Cable para puentes | Global Electronica | 3 | $300 | $900 | Comprado
jumper Dupont M-H | 6 | Cables Dupont para el microfono |  |  |  |  | Pendiente
hembra 2x8 2.54 THT | 2 | Conector de la placa para los 7 electrodos | Global Electronica | 2 | $150 | $300 | Comprado
Skintact FS-RG1/10 32x41 | 50 | Electrodo Ag/AgCl con broche 4 mm |  |  |  |  | Pendiente
INA333 modulo MCU-333 | 4 | INA333 (modulo MCU-333) | MechatronicStore | 4 | $6790 | $27160 | Comprado
INMP441 | 1 | Modulo microfono digital INMP441 (I2S) | Global Electronica | 1 | $7790 | $7790 | Comprado
TS922AIYDT | 6 | Op-amp doble TS922AIYDT (Global 001-TS922) | Global Electronica | 6 | $2890 | $17340 | Comprado
10 x 15 cm | 2 | Perfboard | ya lo tengo |  |  |  | Ya lo tengo
TLV75733PDBVR | 2 | Regulador LDO 3.3 V TLV75733PDBVR (Global 014-75733) | Global Electronica | 2 | $950 | $1900 | Comprado
hembra 1x40 | 1 | Tira de header hembra 1x40 2.54 THT | MechatronicStore | 1 | $490 | $490 | Comprado
macho 1x40 | 1 | Tira de header macho 1x40 2.54 THT | Global Electronica | 1 | $490 | $490 | Comprado
100p | 4 | cond. ceramico C0G | Global Electronica | 4 | $40 | $160 | Comprado
1n | 10 | cond. ceramico C0G | Global Electronica | 10 | $60 | $600 | Comprado
47p | 8 | cond. ceramico C0G | Global Electronica | 8 | $30 | $240 | Comprado
100n | 12 | cond. ceramico/electrolitico | Global Electronica | 12 | $40 | $480 | Comprado
10u | 7 | cond. ceramico/electrolitico | Global Electronica | 7 | $50 | $350 | Comprado
1u | 3 | cond. ceramico/electrolitico | Global Electronica | 3 | $90 | $270 | Comprado
1u X7R | 2 | cond. ceramico/electrolitico | Global Electronica | 2 | $50 | $100 | Comprado
100n | 8 | cond. poliester (film) | Global Electronica | 8 | $40 | $320 | Comprado
100n + 47n en paralelo | 4 | cond. poliester o C0G | Global Electronica | 4 | $130 | $520 | Comprado
10n + 4.7n en paralelo | 4 | cond. poliester o C0G | Global Electronica | 4 | $110 | $440 | Comprado
2.2n | 4 | cond. poliester o C0G | Global Electronica | 4 | $30 | $120 | Comprado
1N4148 | 16 | diodo | Global Electronica | 16 | $20 | $320 | Comprado
100 | 4 | resistencia | Global Electronica | 6 | $50 | $300 | Comprado
100k | 10 | resistencia | Global Electronica | 11 | $178 | $1958 | Comprado
10M | 2 | resistencia | Global Electronica | 4 | $20 | $80 | Comprado
110k | 4 | resistencia | Global Electronica | 6 | $20 | $120 | Comprado
1k | 8 | resistencia | MechatronicStore | 8 | $100 | $800 | Comprado
2.2k | 4 | resistencia | Global Electronica | 5 | $25 | $125 | Comprado
2.4k | 4 | resistencia | Global Electronica | 6 | $20 | $120 | Comprado
2.7k | 10 | resistencia | Global Electronica | 10 | $25 | $250 | Comprado
300k | 4 | resistencia | Global Electronica | 6 | $20 | $120 | Comprado
390k | 2 | resistencia | Global Electronica | 4 | $25 | $100 | Comprado
56k | 12 | resistencia | Global Electronica | 12 | $25 | $300 | Comprado
620k | 4 | resistencia | Global Electronica | 6 | $20 | $120 | Comprado
 |  |  |  |  | TOTAL | $71883
FALTA COMPRAR (no esta en los carritos del 4-oct-2026)
Cant. | Que | Buscar como | Donde | Notas
3 | jumper Dupont M-H Cable a Arduino A1..A3 del STM32N6570-DK | cable dupont macho-hembra (tira de 40) | MechatronicStore / Global. 1 tira de 40 M-H cubre las 3 filas M-H (14 cables) | Compraste 2 de 5
3 | jumper Dupont M-H Cable 5 V y GND desde el DK | cable dupont macho-hembra | MechatronicStore / Global (misma tira M-H) | Usar powerbank o PC a bateria mientras haya electrodos puestos (ver Notas de seguridad)
50 | Skintact FS-RG1/10 32x41 Electrodo Ag/AgCl con broche 4 mm | Skintact FS-RG1/10 / Kendall Arbo H124SG 24 mm | Tiendas de insumos medicos / Mercado Libre | 7 por sesion (6 de senal + 1 RLD); caja de 50. Skintact para CH1, CH3 y RLD. CH2: Arbo H124SG (24 mm) o par sobre el menton. ISIMED 55x55 solo como RLD
8 | broche 4 mm a pin Cable de electrodo con broche (snap) 4 mm, idealmente apantallado | cable electrodo snap 4 mm / cable ECG broche | MechatronicStore ("cable de electrodos AD8232") / tiendas medicas | Uno por electrodo; trenzar los dos de cada par. REVISAR EL TERMINAL antes de comprar: debe calzar en header hembra 2.54 mm. Si termina en DIN 1.5 mm touchproof (DIN 42802), cortar y crimpar terminal Dupont hembra o comprar bases touchproof. Alternativa: cable de 3 electrodos con jack 3.5 mm (el de los kits AD8232) + jack hembra 3.5 mm TRS en la placa
6 | jumper Dupont M-M Bus de 8 cables Dupont macho (separado de una tira de 40) | cable dupont macho-macho 20 cm tira 40 | MechatronicStore / Global. 1 tira de 40 M-M | Compraste 2 de 8
1 | Alcohol isopropilico / gel | alcohol isopropilico | Farmacia / ferreteria | Preparar la piel
6 | jumper Dupont M-H Cables Dupont para el microfono | cable dupont macho-hembra | MechatronicStore / Global (misma tira M-H) | VDD 3.3V, GND, SCK, WS, SD, L/R (L/R a GND)
ARMADO: condensadores en paralelo y polaridades
Cm1 (MFB, x3 canales) = 100 nF (2A104K) EN PARALELO con 47 nF (2A473J): los dos entre el nodo MA (union Rm1-Rm2-Rm3) y GND.
C21 (Sallen-Key, x3 canales) = 10 nF (2A103J) EN PARALELO con 4.7 nF (2A472K): los dos entre la union Rlb1-Rlb2 y la salida del op-amp del SK.
Cm0 (10 uF electrolitico): entre sus patas hay ~0 V DC; cualquier orientacion sirve. Por convencion: + hacia la salida del HPF.
LDO: CM105 (1 uF ceramico) en paralelo con el CE50102 (1 uF electrolitico) a la salida, pegados a los pines OUT y GND.
La simulacion ya usa los valores armados: CM1 = 147n y C21 = 14.7n.
Avisos de la compra
Pedidos hechos el 4-oct-2026: Global $39.433 (retiro en tienda) + MechatronicStore $28.450 (Bluexpress) = $67.883.
Dupont: JPMH20/JPMM20 son cables SUELTOS. Tienes 2 M-H y 2 M-M; el diseno usa 14 M-H y 8 M-M (faltan 12 M-H y 6 M-M; Global tiene stock, $50 c/u).
Falta: electrodos, cables de electrodo y alcohol (ver FALTA COMPRAR).
Resistencias de carbon 5 % en vez de pelicula metalica 1 %: aceptado para la demo (ganancia por canal +-7 %, se normaliza en firmware). Para produccion: 1 %.
Precios con IVA.
