roadtothewest/SSI/docs/afe-emg/BoM_AFE_AuraVox.xlsx

Sheet: BoM por modulo
BoM AFE sEMG AuraVox: 3 canales (submentoniano, labio inferior, laringe), 7 electrodos, RLD. Ordenada por modulo, igual que los recuadros del esquematico LTspice (sim/ltspice).
Carritos del 4-oct-2026 (Global Electronica + MechatronicStore) ya cargados. Celdas amarillas = editables. SEGURIDAD: con electrodos puestos alimentar el DK con powerbank o PC a bateria, nunca con un cargador de pared.
Modulo | Ref. en esquematico | Componente | Valor de diseno | Valor a comprar | Tipo / tolerancia | Cant. por canal | N canales | Cant. total | Repuesto | A comprar | Buscar como | Tienda | Parte en el carrito | Cant. en carrito | Precio unit. (CLP) | Subtotal (CLP) | Estado | Notas
1 PROTECCION ESD |  | por canal (x3)
1 PROTECCION ESD | Rsp, Rsn | Resistencia serie de entrada | 100k | 100k | pelicula metalica 1 % 1/4 W | 2 | 3 | 6 | 2 | 8 | resistencia 100k 1% 1/4W | Global Electronica | R2W100K carbon 2 W 5 % 100k | 8 | $178 | $1424 | Comprado | 2 W en vez de 1/4 W: funciona, pero es grande y caro (11 x $178). Si hay 100k 1/4 W, cambiarla. Limita la corriente de falla hacia el paciente y hacia el INA
1 PROTECCION ESD | Dp1, Dp2, Dn1, Dn2 | Diodo de clamp a VCC y GND | 1N4148 | 1N4148 | diodo de senal | 4 | 3 | 12 | 4 | 16 | 1N4148 | Global Electronica | 1N4148 | 16 | $20 | $320 | Comprado | 4 por canal x 4 = 16 (+4 repuesto = 20). Protegen el INA de descargas
2 FILTRO RFI |  | por canal (x3)
2 FILTRO RFI | Rfp, Rfn | Resistencia del filtro RFI | 1k | 1k | pelicula metalica 1 % | 2 | 3 | 6 | 2 | 8 | resistencia 1k 1% | MechatronicStore | Resistencia carbon 1/4 W 1k (GK3-17) | 8 | $100 | $800 | Comprado
2 FILTRO RFI | Ccmp, Ccmn | Condensador de modo comun | 47p | 47p | ceramico C0G/NP0 5 % | 2 | 3 | 6 | 2 | 8 | condensador ceramico 47pF NP0 | Global Electronica | C470NPO04D disco NPO 47pF 50V | 8 | $30 | $240 | Comprado | Si la simulacion final elige 330k sin Ccm, no se usan
2 FILTRO RFI | Cdif | Condensador diferencial | 100p | 100p | ceramico C0G/NP0 5 % | 1 | 3 | 3 | 1 | 4 | condensador ceramico 100pF NP0 | Global Electronica | RPE110C0G101J050V MLCC C0G 100pF 50V | 4 | $40 | $160 | Comprado
3 AMPLIFICADOR DE INSTRUMENTACION |  | por canal (x3)
3 AMPLIFICADOR DE INSTRUMENTACION | XINA | INA333 (modulo MCU-333) | INA333 | INA333 modulo MCU-333 | modulo; RG: quitar potenciometro | 1 | 3 | 3 | 1 | 4 | modulo MCU-333 INA333 | MechatronicStore | Modulo MCU-333 INA333 (GM2-4) | 4 | $6790 | $27160 | Comprado | Desoldar el trimmer de RG y poner RGa+RGb (2.7k+2.7k) con cable del punto medio al RLD. Alimentar por el pin 3.3V (no VCC) y llevar el pin VREF a tu VREF con buffer. Verificar pines con multimetro. Respaldo: AD623AN DIP-8
3 AMPLIFICADOR DE INSTRUMENTACION | RGa, RGb | Resistencia de ganancia (partida en dos) | 2.61k | 2.7k | pelicula metalica 1 %, parear con multimetro | 2 | 3 | 6 | 4 | 10 | resistencia 2.7k 1% | Global Electronica | 293-2.7K carbon 1/2 W 5 % | 10 | $25 | $250 | Comprado | Con 2 x 2.7k: G1 = 19.5 (diseno 20.16). El punto medio va al RLD
3 AMPLIFICADOR DE INSTRUMENTACION | C desac. INA | Desacople del INA | 100n | 100n | ceramico X7R | 1 | 3 | 3 | 1 | 4 | condensador ceramico 100nF | Global Electronica | K104K10X7RF53L2 MLCC X7R 100nF 50V | 4 | $40 | $160 | Comprado | Pegado al pin de alimentacion
4 HPF 20 Hz (Sallen-Key) |  | por canal (x3)
4 HPF 20 Hz (Sallen-Key) | Chp1, Chp2 | Condensador del HPF | 100n | 100n | poliester/MKT (film) 5 % | 2 | 3 | 6 | 2 | 8 | condensador poliester 100nF 5% | Global Electronica | K104K10X7RF53L2 MLCC X7R 100nF 50V | 8 | $40 | $320 | Comprado | X7R en vez de poliester: f0 del HPF +-10 %, aceptado para la demo. Film, no ceramico: estabilidad y bajo ruido
4 HPF 20 Hz (Sallen-Key) | R1 | Resistencia de realimentacion | 56.2k | 56k | pelicula metalica 1 % | 1 | 3 | 3 | 1 | 4 | resistencia 56k 1% | Global Electronica | 293-56K carbon 1/2 W 5 % | 4 | $25 | $100 | Comprado | Con 56k/110k: f0 = 20.3 Hz, Q = 0.70
4 HPF 20 Hz (Sallen-Key) | Ra | Resistencia a VREF | 113k | 110k | pelicula metalica 1 % | 1 | 3 | 3 | 1 | 4 | resistencia 110k 1% | Global Electronica | 291-110K carbon 1/4 W 5 % | 6 | $20 | $120 | Comprado
4 HPF 20 Hz (Sallen-Key) | XHP | seccion de op-amp | - | - | - |  |  |  |  |  |  |  |  |  |  |  | No aplica | Contada en el modulo 10 OP-AMPS
5 G2 + LPF A: MFB 500 Hz x125 (Q 0.54) |  | por canal (x3)
5 G2 + LPF A: MFB 500 Hz x125 (Q 0.54) | Cm0 | Condensador de bloqueo DC a la entrada del MFB | 10u | 10u | ceramico X7R 16 V o electrolitico BIPOLAR (NP) | 1 | 3 | 3 | 1 | 4 | condensador ceramico 10uF X7R / electrolitico bipolar 10uF | Global Electronica | CE50103 electrolitico 10uF 50V | 4 | $50 | $200 | Comprado | Electrolitico polarizado: aceptable para la demo (DC ~0 V entre sus patas, senal de mV). Para produccion: X7R o bipolar. NO usar electrolitico polarizado: ambos lados quedan en ~1.65 V y la senal lo invierte. Sin Cm0, Ib del TS922 x Ra (110k) x G2 desplaza la salida
5 G2 + LPF A: MFB 500 Hz x125 (Q 0.54) | Rm1 | Resistencia de entrada (fija la ganancia) | 2.4k | 2.4k | pelicula metalica 1 % | 1 | 3 | 3 | 1 | 4 | resistencia 2.4k 1% | Global Electronica | 291-2.4K carbon 1/4 W 5 % | 6 | $20 | $120 | Comprado | Ganancia = Rm2/Rm1 = 125 (total 2500). No poner trimmer aqui: cambia el Q del filtro
5 G2 + LPF A: MFB 500 Hz x125 (Q 0.54) | Rm2 | Resistencia de realimentacion | 300k | 300k | pelicula metalica 1 % | 1 | 3 | 3 | 1 | 4 | resistencia 300k 1% | Global Electronica | 291-300K carbon 1/4 W 5 % | 6 | $20 | $120 | Comprado | Si no hay 300k: 2 x 150k en serie
5 G2 + LPF A: MFB 500 Hz x125 (Q 0.54) | Rm3 | Resistencia a la entrada inversora | 2.2k | 2.2k | pelicula metalica 1 % | 1 | 3 | 3 | 1 | 4 | resistencia 2.2k 1% | Global Electronica | 293-2.2K carbon 1/2 W 5 % | 5 | $25 | $125 | Comprado
5 G2 + LPF A: MFB 500 Hz x125 (Q 0.54) | Cm1 | Condensador a GND = 2 condensadores EN PARALELO | 150n | 100n + 47n en paralelo | poliester 100 V (2A104K + 2A473J) | 1 | 3 | 3 | 1 | 4 | condensador poliester 100nF + 47nF | Global Electronica | 2A104K poliester 100nF 100V + 2A473J poliester 47nF 100V, en paralelo (par) | 4 | $130 | $520 | Comprado | No hay 150 nF en Global: 100n + 47n en paralelo = 147 nF (f0 +1 %, Q -1 %). Cantidad en pares; precio del par ($70 + $60). ARMADO: soldar el 100n y el 47n entre los mismos dos puntos (nodo MA del MFB y GND), patas cortas. 147 nF: f0 +1 %
5 G2 + LPF A: MFB 500 Hz x125 (Q 0.54) | Cm2 | Condensador de realimentacion | 1n | 1n | ceramico C0G/NP0 | 1 | 3 | 3 | 1 | 4 | condensador ceramico 1nF NP0 | Global Electronica | RPE110X7R102K050V MLCC X7R 1nF 50V | 4 | $60 | $240 | Comprado | X7R en vez de C0G: aceptado para la demo
5 G2 + LPF A: MFB 500 Hz x125 (Q 0.54) | XMF | seccion de op-amp | - | - | - |  |  |  |  |  |  |  |  |  |  |  | No aplica | Contada en el modulo 10 OP-AMPS
6 LPF Sallen-Key 500 Hz (Q 1.31) |  | por canal (x3)
6 LPF Sallen-Key 500 Hz (Q 1.31) | Rlb1, Rlb2 | Resistencia del LPF B | 54.9k | 56k | pelicula metalica 1 % | 2 | 3 | 6 | 2 | 8 | resistencia 56k 1% | Global Electronica | 293-56K carbon 1/2 W 5 % | 8 | $25 | $200 | Comprado | Con 56k: f0 = 495 Hz
6 LPF Sallen-Key 500 Hz (Q 1.31) | C21 | Condensador de realimentacion = 2 condensadores EN PARALELO | 15n | 10n + 4.7n en paralelo | poliester 100 V (2A103J + 2A472K) | 1 | 3 | 3 | 1 | 4 | condensador poliester 10nF + 4.7nF | Global Electronica | 2A103J poliester 10nF 100V + 2A472K poliester 4.7nF 100V, en paralelo (par) | 4 | $110 | $440 | Comprado | 15 nF agotado (2A153J en Global; tampoco en MechatronicStore): 10n + 4.7n en paralelo = 14.7 nF (f0 +1 %, Q -1 %). Cantidad en pares; precio del par ($50 + $60). ARMADO: soldar el 10n y el 4.7n entre los mismos dos puntos (union de Rlb1-Rlb2 y la salida del op-amp del SK), patas cortas. 14.7 nF: f0 +1 %
6 LPF Sallen-Key 500 Hz (Q 1.31) | C22 | Condensador a GND | 2.2n | 2.2n | poliester 5 % o C0G | 1 | 3 | 3 | 1 | 4 | condensador poliester 2.2nF | Global Electronica | C222NPO05D disco NPO 2.2nF 50V | 4 | $30 | $120 | Comprado
6 LPF Sallen-Key 500 Hz (Q 1.31) | XLB | seccion de op-amp | - | - | - |  |  |  |  |  |  |  |  |  |  |  | No aplica | Contada en el modulo 10 OP-AMPS
7 BUCKET + SALIDA AL ADC |  | por canal (x3)
7 BUCKET + SALIDA AL ADC | Rbk | Resistencia del bucket | 100 | 100 | pelicula metalica 1 % | 1 | 3 | 3 | 1 | 4 | resistencia 100 ohm 1% | Global Electronica | R1W100 carbon 1 W 100 ohm | 6 | $50 | $300 | Comprado
7 BUCKET + SALIDA AL ADC | Cbk | Condensador del bucket | 1n | 1n | ceramico C0G/NP0 | 1 | 3 | 3 | 1 | 4 | condensador ceramico 1nF NP0 | Global Electronica | RPE110X7R102K050V MLCC X7R 1nF 50V | 4 | $60 | $240 | Comprado
7 BUCKET + SALIDA AL ADC | ADCk | Cable a Arduino A1..A3 del STM32N6570-DK | - | jumper Dupont M-H | - | 1 | 3 | 3 | 2 | 5 | cable dupont macho-hembra (tira de 40) | Global Electronica | JPMH20 cable Dupont M-H 20 cm (1 unidad) | 2 | $50 | $100 | Parcial | Son cables sueltos, no una tira de 40. FALTAN 3. CH1-A1 (PA9), CH2-A2 (PA10), CH3-A3 (PA12). Mas 1 cable de GND. A0 no: comparte ADC con USB1 ISENSE (UM3300)
8 VREF 1.65 V (compartido) |  | compartido
8 VREF 1.65 V (compartido) | RA1, RA2 | Divisor de VREF | 100k | 100k | pelicula metalica 1 % | 2 | 1 | 2 | 0 | 2 | resistencia 100k 1% | Global Electronica | R2W100K carbon 2 W 5 % 100k | 3 | $178 | $534 | Comprado
8 VREF 1.65 V (compartido) | CA | Condensador del divisor | 10u | 10u | ceramico X7R o electrolitico | 1 | 1 | 1 | 0 | 1 | condensador 10uF | Global Electronica | CE50103 electrolitico 10uF 50V | 1 | $50 | $50 | Comprado
8 VREF 1.65 V (compartido) | XVR | seccion de op-amp | - | - | - |  |  |  |  |  |  |  |  |  |  |  | No aplica | Contada en el modulo 10 OP-AMPS
9 RLD (compartido) |  | compartido
9 RLD (compartido) | RSM1..RSM3 | Sensado de modo comun (punto medio de RG) | 604k | 620k | pelicula metalica 1 % | 3 | 1 | 3 | 1 | 4 | resistencia 620k 1% | Global Electronica | 291-620K carbon 1/4 W 5 % | 6 | $20 | $120 | Comprado
9 RLD (compartido) | CINT | Condensador del integrador | 1n | 1n | ceramico C0G/NP0 | 1 | 1 | 1 | 1 | 2 | condensador ceramico 1nF NP0 | Global Electronica | RPE110X7R102K050V MLCC X7R 1nF 50V | 2 | $60 | $120 | Comprado | Si oscila en banco: 2.2n
9 RLD (compartido) | RPAR | Resistencia en paralelo al integrador | 10M | 10M | pelicula 5 % | 1 | 1 | 1 | 1 | 2 | resistencia 10M | Global Electronica | 291-10M carbon 1/4 W 5 % | 4 | $20 | $80 | Comprado
9 RLD (compartido) | RLIM | Resistencia de seguridad al electrodo RLD | 390k | 390k | pelicula metalica 1 % | 1 | 1 | 1 | 1 | 2 | resistencia 390k 1% | Global Electronica | 293-390K carbon 1/2 W 5 % | 4 | $25 | $100 | Comprado | Limita la corriente al paciente
9 RLD (compartido) | XRLD | seccion de op-amp | - | - | - |  |  |  |  |  |  |  |  |  |  |  | No aplica | Contada en el modulo 10 OP-AMPS
10 OP-AMPS (paquetes) |  | compartido
10 OP-AMPS (paquetes) | XHP, XMF, XLB x3, XRLD, XVR | Op-amp doble TS922AIYDT (Global 001-TS922) | TS922 | TS922AIYDT | SOIC-8 | 6 | 1 | 6 | 0 | 6 | TS922AIYDT | Global Electronica | TS922AIYDT | 6 | $2890 | $17340 | Comprado | 11 secciones = 3 por canal x 3 + RLD + VREF (1 libre). Solo habia 6 en stock
10 OP-AMPS (paquetes) | - | Adaptador SOIC-8 a DIP-8 (S08D8, Global; trae PCB y 2 headers de 4) | - | S08D8 | PCB adaptador | 6 | 1 | 6 | 1 | 7 | S08D8 adaptador SOIC 8 a DIP 8 | Global Electronica | S08D8 | 12 | $250 | $3000 | Comprado | En el carrito hay 12; bastan 7 (sobran 5 = $1.250). Solo para los TS922 (SOIC-8, 1.27 mm). NO sirve para el TLV757 (SOT-23) ni para el INA333 (MSOP). Soldar con flux y probar antes de montar
10 OP-AMPS (paquetes) | - | Zocalo DIP-8 (opcional) | - | DIP-8 | zocalo |  |  |  |  |  | zocalo DIP 8 pines |  |  |  |  |  | No aplica | Opcional: soldar los pines del S08D8 directo a la perfboard, o usar tira hembra 2.54 como zocalo
10 OP-AMPS (paquetes) | - | Desacople de cada op-amp | 100n | 100n | ceramico X7R | 6 | 1 | 6 | 2 | 8 | condensador ceramico 100nF | Global Electronica | K104K10X7RF53L2 MLCC X7R 100nF 50V | 8 | $40 | $320 | Comprado | Pegado al pin de alimentacion
11 ALIMENTACION (5 V USB / powerbank -> 3.3 V) |  | compartido
11 ALIMENTACION (5 V USB / powerbank -> 3.3 V) | XLDO | Regulador LDO 3.3 V TLV75733PDBVR (Global 014-75733) | TLV75733P | TLV75733PDBVR | SOT-23-5 | 1 | 1 | 1 | 1 | 2 | TLV75733PDBVR | Global Electronica | TLV75733PDBVR | 2 | $950 | $1900 | Comprado | Entrada 5 V desde el pin +5V del STM32N6570-DK (Arduino CN8). EN unido a IN
11 ALIMENTACION (5 V USB / powerbank -> 3.3 V) | - | Montaje del TLV757 sin adaptador (dead bug) | - | - | - |  |  |  |  |  |  |  |  |  |  |  | No aplica | Pegado boca arriba en la perfboard, hilo fino a cada pata. Pines: 1 IN, 2 GND, 3 EN (a IN), 4 NC, 5 OUT. El SOT23S3 de Global es de 3 pines: no sirve
11 ALIMENTACION (5 V USB / powerbank -> 3.3 V) | CLDOI, CLDOO | Condensadores del LDO (entrada y salida) | 1u | 1u | ceramico X7R | 2 | 1 | 2 | 1 | 3 | condensador ceramico 1uF | Global Electronica | CE50102 electrolitico 1uF 50V | 3 | $90 | $270 | Comprado | Ver la fila CLDOO cer.: a la salida hace falta ademas un ceramico. Pegados a los pines del LDO
11 ALIMENTACION (5 V USB / powerbank -> 3.3 V) | CLDOO cer. | Condensador ceramico de salida del LDO (en paralelo con el electrolitico) | 1u | 1u X7R | MLCC X7R 16 V o mas | 1 | 1 | 1 | 1 | 2 | MLCC THD 1uF X7R | Global Electronica | CM105 MLCC THD 1uF 50V X7R | 2 | $50 | $100 | Comprado | El TLV757 esta pensado para ceramico a la salida (>= 0.47 uF efectivos); un electrolitico solo puede oscilar
11 ALIMENTACION (5 V USB / powerbank -> 3.3 V) | CBULK | Condensador bulk del riel 3.3 V | 10u | 10u | ceramico o electrolitico | 1 | 1 | 1 | 1 | 2 | condensador 10uF | Global Electronica | CE50103 electrolitico 10uF 50V | 2 | $50 | $100 | Comprado
11 ALIMENTACION (5 V USB / powerbank -> 3.3 V) | - | Cable 5 V y GND desde el DK | - | jumper Dupont M-H | - | 2 | 1 | 2 | 1 | 3 | cable dupont macho-hembra |  |  |  |  |  | Pendiente | FALTA EN EL CARRITO. Usar powerbank o PC a bateria mientras haya electrodos puestos (ver Notas de seguridad)
12 ELECTRODOS Y CONECTORES (7) |  | compartido
12 ELECTRODOS Y CONECTORES (7) | XE1P..XE3N, XER | Electrodo Ag/AgCl con broche 4 mm | - | Skintact FS-RG1/10 32x41 | desechable | 7 | 1 | 7 | 43 | 50 | Skintact FS-RG1/10 / Kendall Arbo H124SG 24 mm |  |  |  |  |  | Pendiente | FALTA EN EL CARRITO. 7 por sesion (6 de senal + 1 RLD); caja de 50. Skintact para CH1, CH3 y RLD. CH2: Arbo H124SG (24 mm) o par sobre el menton. ISIMED 55x55 solo como RLD
12 ELECTRODOS Y CONECTORES (7) | - | Cable de electrodo con broche (snap) 4 mm, idealmente apantallado | - | broche 4 mm a pin | - | 7 | 1 | 7 | 1 | 8 | cable electrodo snap 4 mm / cable ECG broche |  |  |  |  |  | Pendiente | FALTA EN EL CARRITO. Uno por electrodo; trenzar los dos de cada par. REVISAR EL TERMINAL antes de comprar: debe calzar en header hembra 2.54 mm. Si termina en DIN 1.5 mm touchproof (DIN 42802), cortar y crimpar terminal Dupont hembra o comprar bases touchproof. Alternativa: cable de 3 electrodos con jack 3.5 mm (el de los kits AD8232) + jack hembra 3.5 mm TRS en la placa
12 ELECTRODOS Y CONECTORES (7) | - | Conector de la placa para los 7 electrodos | - | hembra 2x8 2.54 THT | - | 1 | 1 | 1 | 1 | 2 | 1105-8X2 conector hembra doble fila 16 vias | Global Electronica | 1105-8X2 hembra doble fila 16 vias 2.54 | 2 | $150 | $300 | Comprado | Una fila: CH1+ CH1- CH2+ CH2- CH3+ CH3- RLD GND(malla). Se enchufa el bus Dupont macho
12 ELECTRODOS Y CONECTORES (7) | - | Bus de 8 cables Dupont macho (separado de una tira de 40) | - | jumper Dupont M-M | - | 8 | 1 | 8 | 0 | 8 | cable dupont macho-macho 20 cm tira 40 | Global Electronica | JPMM20 cable Dupont M-M 20 cm (1 unidad) | 2 | $50 | $100 | Parcial | Son cables sueltos, no una tira de 40. FALTAN 6. Lado macho al conector 2x8; el otro extremo se une a los cables de electrodo (soldado + termorretractil o enchufado)
12 ELECTRODOS Y CONECTORES (7) | - | Alcohol isopropilico / gel | - | - | - | 1 | 1 | 1 | 0 | 1 | alcohol isopropilico |  |  |  |  |  | Pendiente | FALTA EN EL CARRITO. Preparar la piel
13 MECANICA E INTERCONEXION |  | compartido
13 MECANICA E INTERCONEXION | - | Perfboard | - | 10 x 15 cm | fibra de vidrio | 1 | 1 | 1 | 1 | 2 | placa perforada 10x15 |  |  |  |  |  | Ya lo tengo
13 MECANICA E INTERCONEXION | - | Tira de header macho 1x40 2.54 THT | - | macho 1x40 | - | 1 | 1 | 1 | 0 | 1 | tira poste recto una fila 40 pines | Global Electronica | 1109-40L tira poste recto una fila 40 pines, pin largo | 1 | $490 | $490 | Comprado | Salidas A1-A3 + GND, 5 V/GND y microfono
13 MECANICA E INTERCONEXION | - | Tira de header hembra 1x40 2.54 THT | - | hembra 1x40 | - | 1 | 1 | 1 | 0 | 1 | tira 40 pines header hembra 2.54 | MechatronicStore | Fila de 40 pines header hembra 2.54 (GD2-3) | 1 | $490 | $490 | Comprado | Zocalo de los 3 modulos INA333 (se cambian sin desoldar)
13 MECANICA E INTERCONEXION | - | Cable para puentes | - | 24 AWG rigido | - | 1 | 1 | 1 | 0 | 1 | cable UTP Cat6 24 AWG unifilar (por metro) | Global Electronica | 6UNI UTP Cat6 4 pares 24 AWG unifilar (m) | 3 | $300 | $900 | Comprado | 3 m. UTP: 8 hilos rigidos por metro. Rigido: no usarlo para los cables de electrodo (se corta al doblarse)
14 MICROFONO DE REFERENCIA (I2S) |  | compartido
14 MICROFONO DE REFERENCIA (I2S) | - | Modulo microfono digital INMP441 (I2S) | - | INMP441 | modulo | 1 | 1 | 1 | 0 | 1 | modulo microfono INMP441 | Global Electronica | INMP441 sensor microfono omnidireccional (pagina 5044) | 1 | $7790 | $7790 | Comprado | A SAI/I2S del STM32N6570-DK (pines por definir en CubeMX). Alternativa sin cableado: microfono MEMS PDM que trae el DK (U13)
14 MICROFONO DE REFERENCIA (I2S) | - | Cables Dupont para el microfono | - | jumper Dupont M-H | - | 6 | 1 | 6 | 0 | 6 | cable dupont macho-hembra |  |  |  |  |  | Pendiente | FALTA EN EL CARRITO. VDD 3.3V, GND, SCK, WS, SD, L/R (L/R a GND)
 |  |  |  |  |  |  |  |  |  |  |  |  |  |  | TOTAL | $67883
FALTA COMPRAR (no esta en los carritos del 4-oct-2026)
Cant. | Que | Buscar como | Donde | Notas
3 | jumper Dupont M-H Cable a Arduino A1..A3 del STM32N6570-DK | cable dupont macho-hembra (tira de 40) | MechatronicStore / Global. 1 tira de 40 M-H cubre las 3 filas M-H (14 cables) | Compraste 2 de 5
3 | jumper Dupont M-H Cable 5 V y GND desde el DK | cable dupont macho-hembra | MechatronicStore / Global (misma tira M-H) | Usar powerbank o PC a bateria mientras haya electrodos puestos (ver Notas de seguridad)
50 | Skintact FS-RG1/10 32x41 Electrodo Ag/AgCl con broche 4 mm | Skintact FS-RG1/10 / Kendall Arbo H124SG 24 mm | Tiendas de insumos medicos / Mercado Libre | 7 por sesion (6 de senal + 1 RLD); caja de 50. Skintact para CH1, CH3 y RLD. CH2: Arbo H124SG (24 mm) o par sobre el menton. ISIMED 55x55 solo como RLD
8 | broche 4 mm a pin Cable de electrodo con broche (snap) 4 mm, idealmente apantallado | cable electrodo snap 4 mm / cable ECG broche | MechatronicStore ("cable de electrodos AD8232") / tiendas medicas | Uno por electrodo; trenzar los dos de cada par. REVISAR EL TERMINAL antes de comprar: debe calzar en header hembra 2.54 mm. Si termina en DIN 1.5 mm touchproof (DIN 42802), cortar y crimpar terminal Dupont hembra o comprar bases touchproof. Alternativa: cable de 3 electrodos con jack 3.5 mm (el de los kits AD8232) + jack hembra 3.5 mm TRS en la placa
6 | jumper Dupont M-M Bus de 8 cables Dupont macho (separado de una tira de 40) | cable dupont macho-macho 20 cm tira 40 | MechatronicStore / Global. 1 tira de 40 M-M | Compraste 2 de 8
1 | Alcohol isopropilico / gel | alcohol isopropilico | Farmacia / ferreteria | Preparar la piel
6 | jumper Dupont M-H Cables Dupont para el microfono | cable dupont macho-hembra | MechatronicStore / Global (misma tira M-H) | VDD 3.3V, GND, SCK, WS, SD, L/R (L/R a GND)

Sheet: Resumen
Resumen por modulo
Modulo | Items | Pendientes | Subtotal (CLP)
1 PROTECCION ESD | 2 | 0 | $1744
2 FILTRO RFI | 3 | 0 | $1200
3 AMPLIFICADOR DE INSTRUMENTACION | 3 | 0 | $27570
4 HPF 20 Hz (Sallen-Key) | 3 | 0 | $540
5 G2 + LPF A: MFB 500 Hz x125 (Q 0.54) | 6 | 0 | $1325
6 LPF Sallen-Key 500 Hz (Q 1.31) | 3 | 0 | $760
7 BUCKET + SALIDA AL ADC | 3 | 0 | $640
8 VREF 1.65 V (compartido) | 2 | 0 | $584
9 RLD (compartido) | 4 | 0 | $420
10 OP-AMPS (paquetes) | 3 | 0 | $20660
11 ALIMENTACION (5 V USB / powerbank -> 3.3 V) | 5 | 1 | $2370
12 ELECTRODOS Y CONECTORES (7) | 5 | 3 | $400
13 MECANICA E INTERCONEXION | 4 | 0 | $1880
14 MICROFONO DE REFERENCIA (I2S) | 2 | 1 | $7790
TOTAL | 48 | 5 | $67883
Tienda | Comprado (CLP) | En carrito / por agregar (CLP)
Global Electronica | $39433 | $0
MechatronicStore | $28450 | $0
Faltan en los carritos
3 x jumper Dupont M-H Cable 5 V y GND desde el DK | cable dupont macho-hembra
50 x Skintact FS-RG1/10 32x41 Electrodo Ag/AgCl con broche 4 mm | Skintact FS-RG1/10 / Kendall Arbo H124SG 24 mm
8 x broche 4 mm a pin Cable de electrodo con broche (snap) 4 mm, idealmente apantallado | cable electrodo snap 4 mm / cable ECG broche
1 x Alcohol isopropilico / gel | alcohol isopropilico
2 x 10 x 15 cm Perfboard | placa perforada 10x15
6 x jumper Dupont M-H Cables Dupont para el microfono | cable dupont macho-hembra
Pedidos
Global Electronica: Pedido BVGDHKTGU (4-oct-2026), retiro en tienda Global (Vina del Mar). Total $39.433
MechatronicStore: Pedido del 4-oct-2026, despacho Bluexpress (gratis). Total $28.450
ARMADO: condensadores en paralelo y polaridades
Cm1 (MFB, x3 canales) = 100 nF (2A104K) EN PARALELO con 47 nF (2A473J): los dos entre el nodo MA (union Rm1-Rm2-Rm3) y GND.
C21 (Sallen-Key, x3 canales) = 10 nF (2A103J) EN PARALELO con 4.7 nF (2A472K): los dos entre la union Rlb1-Rlb2 y la salida del op-amp del SK.
Cm0 (10 uF electrolitico): entre sus patas hay ~0 V DC; cualquier orientacion sirve. Por convencion: + hacia la salida del HPF.
LDO: CM105 (1 uF ceramico) en paralelo con el CE50102 (1 uF electrolitico) a la salida, pegados a los pines OUT y GND.
La simulacion ya usa los valores armados: CM1 = 147n y C21 = 14.7n.
Avisos de la compra
Pedidos hechos el 4-oct-2026: Global $39.433 (retiro en tienda) + MechatronicStore $28.450 (Bluexpress) = $67.883.
Dupont: JPMH20/JPMM20 son cables SUELTOS. Tienes 2 M-H y 2 M-M; el diseno usa 14 M-H y 8 M-M (faltan 12 M-H y 6 M-M; Global tiene stock, $50 c/u).
Falta: electrodos, cables de electrodo y alcohol (ver FALTA COMPRAR).
Resistencias de carbon 5 % en vez de pelicula metalica 1 %: aceptado para la demo (ganancia por canal +-7 %, se normaliza en firmware). Para produccion: 1 %.
Precios con IVA.

Sheet: Requisitos IC
Condiciones que debe cumplir cada circuito integrado (para elegir reemplazos)
OP-AMP (reemplazo del MCP6004): 22 secciones = HPF, G2, LPF A, LPF B y buffer en cada canal + RLD + VREF
Parametro | Requisito | Por que (en este diseno)
Alimentacion unica | Funciona con 3.3 V: Vmin <= 3.0 V (ideal <= 2.7 V), Vmax >= 3.6 V | Todo el AFE vive en 3.3 V a bateria
Salida rail-to-rail | Llega a <= 0.1 V de cada riel con 10 kohm | La salida va de 0 a 3.3 V centrada en 1.65 V. LM358/LM324 no suben de ~1.8 V con 3.3 V
Rango de entrada en modo comun | Minimo 0.8-2.5 V (VREF +-0.85 V); ideal rail-to-rail | En los filtros y buffers la entrada sigue a la salida
Producto ganancia-ancho de banda (GBW) | >= 0.5 MHz (ideal >= 1 MHz) | G2 = 125 hasta 500 Hz (necesita >= 0.3 MHz; TS922 ~4 MHz) y LPF con Q = 1.3
Estable a ganancia 1 | Si | HPF, LPF y buffers son seguidores
Corriente de polarizacion | <= 10 nA (entrada CMOS ideal) | Resistencias de 56-240 kohm: 10 nA x 110k = 1.1 mV
Offset | <= 5 mV | G2 tiene ganancia 1 en DC: el offset no se amplifica
Ruido de entrada | <= 40 nV/rtHz | Va despues de G1 = 20: no domina
Consumo | <= 0.5 mA por amplificador | Bateria
Encapsulado | DIP-8/DIP-14, o SOIC con adaptador | Perfboard
SI sirven | MCP6004/MCP6002, MCP604/MCP602, MCP6024/MCP6022, TLV2374/TLV2372, OPA4340/OPA2340, OPA4344/OPA2344, AD8608/AD8606
Con reservas | LMV324/LMV358 (entrada solo hasta V+ - 0.8 V; alcanza para +-0.85 V; suelen ser SMD)
NO sirven | LM358, LM324, TL071/TL072/TL074, NE5532, LM741, LF347, JRC4558, LM833, TLC2272 (no llegan a los rieles con 3.3 V o necesitan mas voltaje)
INA (amplificador de instrumentacion): 4 unidades, una por canal
Parametro | Requisito | Por que (en este diseno)
Alimentacion unica | Funciona con 3.3 V: Vmin <= 3.0 V | Mismo riel que los op-amps
Salida | Rail-to-rail, o al menos 0.2-3.1 V | La salida se centra en VREF = 1.65 V
Rango de entrada en modo comun | Debe incluir 1.4-1.9 V con alimentacion de 3.3 V | El RLD mantiene el cuerpo en VREF = 1.65 V
Ganancia | Fijada por una sola RG, con los dos pines de RG accesibles | El RLD sensa el punto medio de RG. Un modulo con potenciometro obliga a reemplazarlo por 2 resistencias
Formula de ganancia | G = 1 + 100k/RG: INA333, AD623, AD8226, INA826 (RG = 2 x 2.7k). INA122: G = 5 + 200k/RG. INA126: G = 5 + 80k/RG | G1 objetivo ~20
CMRR | >= 90 dB a G = 20 (DC a 50 Hz) | Rechazo del 50 Hz de la red
Corriente de polarizacion | <= 25 nA | Con 100k de proteccion: <= 2.5 mV de offset
Ruido de entrada | <= 50 nV/rtHz | Senal sEMG de 25-50 uV RMS
Ancho de banda a G = 20 | >= 5 kHz | Banda util 20-500 Hz
Encapsulado | DIP-8, o SOIC/MSOP con adaptador, o modulo con RG accesible | Perfboard
SI sirven | INA333 (ideal), AD8226, INA826
Con reservas | AD623 (modo comun max ~ Vs - 1.5 V = 1.8 V con 3.3 V: margen de 0.15 V sobre VREF); INA122/INA126 (recalcular RG) | AD623AN DIP-8: 2 u por CLP 16.170 en Mercado Libre (30-sep-2026)
NO sirven | AD620, INA128, INA129, INA114, INA118 (necesitan ~4.6 V o mas y no tienen salida rail-to-rail); AD8232 (frontend completo de 1 canal, choca con el RLD compartido)
LDO 3.3 V (alimentacion del AFE)
Parametro | Requisito | Por que (en este diseno)
Salida | 3.3 V fija, >= 50 mA | AFE completo consume < 10 mA
Entrada | Hasta >= 6 V; dropout <= 0.3 V a 20 mA | 3 pilas AA = 4.5 V nueva, ~3.6 V gastada
Estabilidad | Estable con condensadores ceramicos
SI sirven | MCP1700-3302E (TO-92), MCP1702-3302, LP2950-3.3, HT7333 | MCP1700: CLP 890 en hubot.cl
Con reservas | AMS1117-3.3 (dropout ~1.1 V: usar 4 pilas AA)
NO sirve | El LDO de 3.0 V que ya tienes

Sheet: Tiendas
Donde buscar (datos revisados el 30-sep-2026)
Tienda | Ubicacion | Modalidad | Que tiene / buscar | Web
Global Electronica | Santiago | Web y tienda | TS922AIYDT, TLV75733PDBVR, S08D8, pasivos, conectores, INMP441 (carrito del 4-oct) | globalelectronica.cl
Katode | San Martin 133 E, Santiago Centro | Retiro el mismo dia, L-V 9:30-14:00 | Pasivos, zocalos, perfboard. Op-amps solo clasicos (TL07x, NE5532): NO sirven | katode.cl
HUBOT | Santiago | Despacho el mismo dia si se pide antes de las 12:30 | MCP1700-3302E (CLP 890) | hubot.cl
MCI Electronics | Santiago | Retiro en tienda 8:30-17:30 | Kits de resistencias 1 %, modulos | mcielectronics.cl
Afel | Santiago | Tienda y web | Pasivos y kits | afel.cl
MechatronicStore | Curico | Envio; gratis sobre CLP 19.990 | Modulo INA333 MCU-333 (CLP 6.790; RG es potenciometro), poliester | mechatronicstore.cl
Mercado Libre | - | Filtrar "Llega hoy" y vendedores de Santiago | AD623AN DIP-8 (2 u CLP 16.170), electrodos 3M 2228, cables con broche | mercadolibre.cl
RS Chile | - | Web, plazos segun stock | MCP6004-E/P CLP 809 c/IVA, minimo 30 u, sin stock al 30-sep | cl.rsdelivers.com
Klinetix | Santiago | Despacho 1-2 dias habiles en RM | Electrodos 3M 2228 caja de 50 (agotado al 30-sep) | klinetix.cl
DigiKey / Mouser | EE.UU. | 2-5 dias habiles, impuestos al recibir | Cualquier IC de la lista SI sirven | digikey.com / mouser.cl
