roadtothewest/SSI/ssr-testbed/pc-tools/auravoxd/ml/testdata/etiquetas.csv

archivo | clase | ronda | cond_hmi
a-espaciada.avx | a |  | vocal
a-espaciada2.avx | a |  | vocal
a-sostenida.avx | a |  | vocal
a-sostenida2.avx | a |  | vocal
e-espaciada.avx | e |  | vocal
e-espaciada2.avx | e |  | vocal
e-sostenida.avx | e |  | vocal
e-sostenida2.avx | e |  | vocal
i-espaciada.avx | i |  | vocal
i-espaciada2.avx | i |  | vocal
i-sostenida.avx | i |  | vocal
i-sostenida2.avx | i |  | vocal
o-espaciada.avx | o |  | vocal
o-espaciada2.avx | o |  | vocal
o-sostenida.avx | o |  | vocal
o-sostenida2.avx | o |  | vocal
silencio1.avx | reposo |  | reposo
silencio2.avx | reposo |  | reposo
silencio3.avx | reposo |  | reposo
silencio4.avx | reposo |  | reposo
u-espaciada.avx | u |  | vocal
u-espaciada2.avx | u |  | vocal
u-sostenida.avx | u |  | vocal
u-sostenida2.avx | u |  | vocal
