roadtothewest/SSI/sim/ltspice/AuraVox_AFE.asc

BIN1: bv; V=V(semg1)+{KN}*({NMOV}*white(3*time+7e3)+{NWHT}*white(2e4*time+3e5)+{GE1}*V(ecg))
BIN2: bv; V=V(semg2)+{KN}*({NMOV}*white(3*time+14e3)+{NWHT}*white(2e4*time+6e5)+{GE2}*V(ecg))
BIN3: bv; V=V(semg3)+{KN}*({NMOV}*white(3*time+21e3)+{NWHT}*white(2e4*time+9e5)+{GE3}*V(ecg))
BSEM1: bv; V={AS1}*{KSEM}*V(f1)*V(env)
BSEM2: bv; V={AS2}*{KSEM}*V(f2)*V(env)
BSEM3: bv; V={AS3}*{KSEM}*V(f3)*V(env)
BW1: bv; V=white(2e4*time+1e5)
BW2: bv; V=white(2e4*time+2e5)
BW3: bv; V=white(2e4*time+3e5)
CA: cap; 10u
CBE: cap; 200p
CBULK: cap; 10u
CGE: cap; {CGE}
CI1: cap; 47n
CI2: cap; 47n
CI3: cap; 47n
CINT: cap; {CINT}
CLDOI: cap; 1u
CLDOO: cap; 1u
CMB: cap; {CMB}
CSEM1: cap; {CSEM}
CSEM2: cap; {CSEM}
CSEM3: cap; {CSEM}
CSH1: cap; 5p
CSH2: cap; 5p
CSH3: cap; 5p
EDK1: e; {GDK}
EDK2: e; {GDK}
EDK3: e; {GDK}
LSEM1: ind; {LSEM}
LSEM2: ind; {LSEM}
LSEM3: ind; {LSEM}
RA1: res; 100k
RA2: res; 100k
RDK1: res; 1k
RDK2: res; 1k
RDK3: res; 1k
RDKIN1: res; 1Meg
RDKIN2: res; 1Meg
RDKIN3: res; 1Meg
RGE: res; 1G
RI1: res; {RIMB}
RI2: res; {RIMB}
RI3: res; {RIMB}
RLIM: res; {RLIM}
RPAR: res; 10Meg
RSEM1: res; {RSEM}
RSEM2: res; {RSEM}
RSEM3: res; {RSEM}
RSM1: res; {RSM}
RSM2: res; {RSM}
RSM3: res; {RSM}
VECG: voltage; PWL REPEAT FOREVER (0 0 0.08 0 0.12 0.12 0.16 0 0.20 -0.12 0.22 1 0.24 -0.25 0.27 0 0.42 0 0.50 0.3 0.58 0 0.833 0) ENDREPEAT
VENV: voltage; PULSE(0.05 1 0.3 30m 30m 170m 420m)
VM: voltage; SINE(0 {VMAINS_TRAN} 50) AC {VMAINS_AC}
VUSB: voltage; 5
XCH1: CANAL
XCH2: CANAL
XCH3: CANAL
XE1N: ELECTRODO; ELECTRODE; Vhc=-5m
XE1P: ELECTRODO; ELECTRODE; Vhc=5m
XE2N: ELECTRODO; ELECTRODE; Vhc=0
XE2P: ELECTRODO; ELECTRODE; Vhc=12m
XE3N: ELECTRODO; ELECTRODE; Vhc=10m
XE3P: ELECTRODO; ELECTRODE; Vhc=-8m
XER: ELECTRODO; ELECTRODE; Vhc=0 Re={RER}
XLDO: TLV75733P
XRLD: opamp2; TS922
XVR: opamp2; TS922
Named nets: V5, 0, VCC, VREF, env, ecg, MAINS, EARTH, BODY, w1, lc1, f1, semg1, n1, EP1, EN1, RGM1, adc1, pin1, w2, lc2, f2, semg2, n2, EP2, EN2, RGM2, adc2, pin2, w3, lc3, f3, semg3, n3, EP3, EN3, RGM3, adc3, pin3, RLDO
AuraVox - AFE sEMG: 3 entradas diferenciales (7 electrodos) -> 3 salidas al ADC del STM32N6570-DK
Un Run = 2 pasos: paso 1 SIN RLD (referencia pasiva 390k), paso 2 CON RLD. Resultados: View > SPICE Error Log. Doble clic en un bloque CANAL para ver sus 8 etapas.
QUE GRAFICAR: V(semg1) (sEMG limpio) | V(n1)-V(body) (entrada con ruido) | V(adc1)..V(adc3) (salidas del AFE) | V(pin1)..V(pin3) (lo que ve el ADC, 0-1.8 V) | V(body)-V(vref) (modo comun)
ALIMENTACION: 5 V USB/powerbank -> TLV75733P -> 3.3 V, Y VREF
5 V desde el pin +5V del STM32N6570-DK; divisor 2 x 100k + 10u y seguidor TS922
GENERADORES COMUNES
envolvente de habla (rafagas) y ECG
CUERPO Y RED 50 Hz
CMB red-cuerpo, CBE cuerpo-tierra, CGE circuito-tierra (1 = USB a PC, peor caso)
ENTRADA DIFERENCIAL POR CANAL
sEMG = ruido blanco filtrado 90 Hz x envolvente; ruido = movimiento + ECG + blanco
ELECTRODOS (6 de senal)
20k||47n; el - de cada par + 51k||47n
AFE: 3 CANALES
bloque CANAL = 7 etapas
STM32N6570-DK: ARDUINO A1..A3
amplificador de la placa 3.3 V -> 1.8 V + muestreo del ADC
CH1  submentoniano
CH1 -> A1 = PA9 (ADC12_INP10)
CH2  labio inferior
CH2 -> A2 = PA10 (ADC12_INP11)
CH3  laringe
CH3 -> A3 = PA12 (ADC12_INP13)
RLD (7o electrodo, clavicula)
integrador inversor; sensa el punto medio de RG de los 3 canales
Salida del integrador -> RLIM 390k -> electrodo RLD. Para probar SIN RLD: borra el cable marcado y vuelve a dar Run
^ cable RLD -> electrodo: borralo para probar sin RLD
VALORES (editar aqui si cambias un componente)
E24; el bloque CANAL los usa en sus 3 copias
.param RS=100k RRFI=1k CCM=47p CD=100p RGH=2.7k
.param CHP=100n RHP1=56k RHP2=110k
.param CM0=10u RM1=2.4k RM2=300k RM3=2.2k CM1=147n CM2=1n
.param RLB=56k C21=14.7n C22=2.2n
.param RBK=100 CBK=1n RSM=620k CINT=1n RLIM=390k
ESTIMULO Y SIMULACION
KN=0 quita el ruido. AS = sEMG (V rms); GE = ECG pico; NMOV/NWHT calibrados a 500/20 uV rms
.param KN=1 KSEM=25 LSEM=1 CSEM=3.127u RSEM=807.8 NMOV=4.28m NWHT=82.4u
.param AS1=50u AS2=40u AS3=25u
.param GE1=120u GE2=50u GE3=250u
.param CMB=3p RIMB=51k RER=20k CGE=1 VMAINS_TRAN=311 VMAINS_AC=0
.param GDK={1.8/3.3}
.include opa.lib
.include models/ina_behav.lib
.include afe_channel.lib
.include models/tlv757_behav.lib
.tran 0 1.2 0 50u
.options gmin=100f plotwinsize=0 gminsteps=0 srcsteps=0
.meas tran VCC_V AVG V(vcc) FROM 0.3 TO 1.2
.meas tran VREF_V AVG V(vref) FROM 0.3 TO 1.2
.meas tran CM_cuerpo_Vpp PP V(body)-V(vref) FROM 0.3 TO 1.2
.meas tran sEMG1_uVrms RMS 1e6*V(semg1) FROM 0.35 TO 0.49
.meas tran ADC1_DC_V AVG V(adc1) FROM 0.3 TO 1.2
.meas tran ADC1_pk_V MAX abs(V(adc1,vref)) FROM 0.3 TO 1.2
.meas tran m1r AVG 1000*V(adc1,vref) FROM 0.35 TO 0.49
.meas tran q1r RMS 1000*V(adc1,vref) FROM 0.35 TO 0.49
.meas tran m1s AVG 1000*V(adc1,vref) FROM 0.58 TO 0.70
.meas tran q1s RMS 1000*V(adc1,vref) FROM 0.58 TO 0.70
.meas tran ADC1_rafaga_mVrms param sqrt(q1r**2-m1r**2)
.meas tran ADC1_reposo_mVrms param sqrt(q1s**2-m1s**2)
.meas tran SNR1_salida_dB param 20*log10(ADC1_rafaga_mVrms/ADC1_reposo_mVrms)
.meas tran PIN1_min_V MIN V(pin1) FROM 0.3 TO 1.2
.meas tran PIN1_max_V MAX V(pin1) FROM 0.3 TO 1.2
.meas tran sEMG2_uVrms RMS 1e6*V(semg2) FROM 0.35 TO 0.49
.meas tran ADC2_DC_V AVG V(adc2) FROM 0.3 TO 1.2
.meas tran ADC2_pk_V MAX abs(V(adc2,vref)) FROM 0.3 TO 1.2
.meas tran m2r AVG 1000*V(adc2,vref) FROM 0.35 TO 0.49
.meas tran q2r RMS 1000*V(adc2,vref) FROM 0.35 TO 0.49
.meas tran m2s AVG 1000*V(adc2,vref) FROM 0.58 TO 0.70
.meas tran q2s RMS 1000*V(adc2,vref) FROM 0.58 TO 0.70
.meas tran ADC2_rafaga_mVrms param sqrt(q2r**2-m2r**2)
.meas tran ADC2_reposo_mVrms param sqrt(q2s**2-m2s**2)
.meas tran SNR2_salida_dB param 20*log10(ADC2_rafaga_mVrms/ADC2_reposo_mVrms)
.meas tran PIN2_min_V MIN V(pin2) FROM 0.3 TO 1.2
.meas tran PIN2_max_V MAX V(pin2) FROM 0.3 TO 1.2
.meas tran sEMG3_uVrms RMS 1e6*V(semg3) FROM 0.35 TO 0.49
.meas tran ADC3_DC_V AVG V(adc3) FROM 0.3 TO 1.2
.meas tran ADC3_pk_V MAX abs(V(adc3,vref)) FROM 0.3 TO 1.2
.meas tran m3r AVG 1000*V(adc3,vref) FROM 0.35 TO 0.49
.meas tran q3r RMS 1000*V(adc3,vref) FROM 0.35 TO 0.49
.meas tran m3s AVG 1000*V(adc3,vref) FROM 0.58 TO 0.70
.meas tran q3s RMS 1000*V(adc3,vref) FROM 0.58 TO 0.70
.meas tran ADC3_rafaga_mVrms param sqrt(q3r**2-m3r**2)
.meas tran ADC3_reposo_mVrms param sqrt(q3s**2-m3s**2)
.meas tran SNR3_salida_dB param 20*log10(ADC3_rafaga_mVrms/ADC3_reposo_mVrms)
.meas tran PIN3_min_V MIN V(pin3) FROM 0.3 TO 1.2
.meas tran PIN3_max_V MAX V(pin3) FROM 0.3 TO 1.2
BoM (3 canales, a comprar; detalle en docs/afe-emg/BoM_AFE_AuraVox.xlsx)
10 x 100k  resistencia
  4 x 100p  cond. ceramico C0G
  8 x 100n  cond. poliester (film)
  4 x 2.4k  resistencia
 10 x 1n  cond. ceramico C0G
  5 x jumper Dupont M-H  Cable a Arduino A1..A3 del STM32N6570-DK
  6 x TS922AIYDT  Op-amp doble TS922AIYDT (Global 001-TS922)
  2 x 1u X7R  cond. ceramico/electrolitico
  2 x hembra 2x8 2.54 THT  Conector de la placa para los 7 electrodos
  1 x macho 1x40  Tira de header macho 1x40 2.54 THT
  6 x jumper Dupont M-H  Cables Dupont para el microfono
16 x 1N4148  diodo
  4 x INA333 modulo MCU-333  INA333 (modulo MCU-333)
 12 x 56k  resistencia
  4 x 300k  resistencia
  4 x 10n + 4.7n en paralelo  cond. poliester o C0G
  4 x 620k  resistencia
  7 x S08D8  Adaptador SOIC-8 a DIP-8 (S08D8, Global; trae PCB y 2 headers de 4)
  3 x jumper Dupont M-H  Cable 5 V y GND desde el DK
  8 x jumper Dupont M-M  Bus de 8 cables Dupont macho (separado de una tira de 40)
  1 x hembra 1x40  Tira de header hembra 1x40 2.54 THT
8 x 1k  resistencia
 10 x 2.7k  resistencia
  4 x 110k  resistencia
  4 x 2.2k  resistencia
  4 x 2.2n  cond. poliester o C0G
  2 x 10M  resistencia
  2 x TLV75733PDBVR  Regulador LDO 3.3 V TLV75733PDBVR (Global 014-75733)
 50 x Skintact FS-RG1/10 32x41  Electrodo Ag/AgCl con broche 4 mm
  1 x Alcohol isopropilico / gel  Alcohol isopropilico / gel
  1 x 24 AWG rigido  Cable para puentes
8 x 47p  cond. ceramico C0G
 12 x 100n  cond. ceramico/electrolitico
  7 x 10u  cond. ceramico/electrolitico
  4 x 100n + 47n en paralelo  cond. poliester o C0G
  4 x 100  resistencia
  2 x 390k  resistencia
  3 x 1u  cond. ceramico/electrolitico
  8 x broche 4 mm a pin  Cable de electrodo con broche (snap) 4 mm, idealmente apantallado
  2 x 10 x 15 cm  Perfboard
  1 x INMP441  Modulo microfono digital INMP441 (I2S)
