roadtothewest/SSI/sim/ltspice/CANAL.asc

C21: cap; {C21}
C22: cap; {C22}
Cbk: cap; {CBK}
Ccmn: cap; {CCM}
Ccmp: cap; {CCM}
Cdif: cap; {CD}
Chp1: cap; {CHP}
Chp2: cap; {CHP}
Cm0: cap; {CM0}
Cm1: cap; {CM1}
Cm2: cap; {CM2}
Dn1: diode; 1N4148
Dn2: diode; 1N4148
Dp1: diode; 1N4148
Dp2: diode; 1N4148
R1: res; {RHP1}
Ra: res; {RHP2}
Rbk: res; {RBK}
Rfn: res; {RRFI}
Rfp: res; {RRFI}
RGa: res; {RGH}
RGb: res; {RGH}
Rlb1: res; {RLB}
Rlb2: res; {RLB}
Rm1: res; {RM1}
Rm2: res; {RM2}
Rm3: res; {RM3}
Rsn: res; {RS}
Rsp: res; {RS}
XHP: opamp2; TS922
XINA: INA333
XLB: opamp2; TS922
XMF: opamp2; TS922
Named nets: VCC, VREF, EP, EN, 0, RGM, INAOUT, HPO, MFO, LBO, ADC
CANAL sEMG:  EP/EN  ->  1 ESD  ->  2 RFI  ->  3 INA333 x20  ->  4 HPF 20 Hz  ->  5 G2 + LPF A (MFB x125)  ->  6 LPF B + buffer (SK x1)  ->  7 RC  ->  ADC
Ganancia total 503 (54 dB), banda 20-500 Hz. Este bloque se usa 3 veces en AuraVox_AFE.asc (XCH1..XCH3). Nombres = subcircuito AFE_CH de afe_channel.lib
Alimentacion
1  PROTECCION ESD
Rs {RS} + 1N4148 a VCC y GND
2  FILTRO RFI
Rf 1k, Ccm {CCM}, Cd {CD}
3  INA333, G1 = 20.16
G1 = 1+100k/RG, RG = 2 x 2.61k
punto medio RGM -> RLD
4  HPF 20 Hz  (Sallen-Key 2o orden)
ganancia 1, Q 0.707
5  G2 + LPF etapa A: MFB 500 Hz, ganancia -125 (Q 0.54)
ARMADO: Cm1 = 100n || 47n poliester (147n). Cm0 bloquea la DC; invierte (no importa)
6  LPF etapa B + BUFFER: Sallen-Key 500 Hz, ganancia 1 (Q 1.31)
ARMADO: C21 = 10n || 4.7n poliester (14.7n). MFB + SK = Butterworth 4o orden
7  RC -> ADC
100 ohm + 1 nF
