roadtothewest/SSI/sim/ltspice/AFE_4CH.asc

BIN1: bv; V=stim({F1},V(nl1),V(nw1))
BIN2: bv; V=stim({F2},V(nl2),V(nw2))
BIN3: bv; V=stim({F3},V(nl3),V(nw3))
BIN4: bv; V=stim({F4},V(nl4),V(nw4))
CA: cap; 10u
CBE: cap; 200p
CGE: cap; {CGE}
CI1: cap; 47n
CI2: cap; 47n
CI3: cap; 47n
CI4: cap; 47n
CINT: cap; {CINT}
CMB: cap; {CMB}
RA1: res; 100k
RA2: res; 100k
RGE: res; 1G
RI1: res; {RIMB}
RI2: res; {RIMB}
RI3: res; {RIMB}
RI4: res; {RIMB}
RLIM: res; {RLIM_EF}
RPAR: res; 10Meg
RPAS: res; {RPAS_EF}
RSM1: res; 604k
RSM2: res; 604k
RSM3: res; 604k
RSM4: res; 604k
VCC: voltage; 3.3
VL1: voltage; PWL file=noise/lf_ch1.pwl
VL2: voltage; PWL file=noise/lf_ch2.pwl
VL3: voltage; PWL file=noise/lf_ch3.pwl
VL4: voltage; PWL file=noise/lf_ch4.pwl
VM: voltage; SINE(0 {VMAINS_TRAN} 50) AC {VMAINS_AC}
VW1: voltage; PWL file=noise/wh_ch1.pwl
VW2: voltage; PWL file=noise/wh_ch2.pwl
VW3: voltage; PWL file=noise/wh_ch3.pwl
VW4: voltage; PWL file=noise/wh_ch4.pwl
XCH1: CANAL
XCH2: CANAL
XCH3: CANAL
XCH4: CANAL
XE1N: ELECTRODO; ELECTRODE; Vhc=-5m
XE1P: ELECTRODO; ELECTRODE; Vhc=5m
XE2N: ELECTRODO; ELECTRODE; Vhc=0
XE2P: ELECTRODO; ELECTRODE; Vhc=12m
XE3N: ELECTRODO; ELECTRODE; Vhc=10m
XE3P: ELECTRODO; ELECTRODE; Vhc=-8m
XE4N: ELECTRODO; ELECTRODE; Vhc=-15m
XE4P: ELECTRODO; ELECTRODE; Vhc=3m
XER: ELECTRODO; ELECTRODE; Vhc=0 Re={RER}
XRLD: opamp2; OPA
XVR: opamp2; OPA
Named nets: VCC, 0, VREF, MAINS, EARTH, BODY, nl1, nw1, n1, EP1, EN1, ADC1, RGM1, INA1, nl2, nw2, n2, EP2, EN2, ADC2, RGM2, INA2, nl3, nw3, n3, EP3, EN3, ADC3, RGM3, INA3, nl4, nw4, n4, EP4, EN4, ADC4, RGM4, INA4, RLDO
AuraVox - AFE sEMG: 4 canales diferenciales, 9 electrodos (4 pares + RLD), 4 salidas ADC1..ADC4
Prueba general: senoidal (73/131/211/307 Hz) 10x menor que el ruido en los 4 canales, RLD activo, USB a PC
Flujo: ESTIMULO -> ELECTRODOS -> CANAL (x4) -> ADC.  Doble clic en un bloque CANAL (o clic derecho > Open Hierarchy) para ver sus 8 etapas.
ALIMENTACION 3.3 V Y VREF 1.65 V
divisor 2 x 100k + 10u, seguidor MCP6004
CUERPO Y RED 50 Hz
CMB red-cuerpo, CBE cuerpo-tierra, CGE circuito-tierra (20p bateria, 1 = USB a PC)
ESTIMULO POR CANAL
diferencial, entre el cuerpo y el electrodo +
ELECTRODOS (8 de senal)
20k||47n; el - de cada par + 51k||47n
AFE: 4 CANALES
bloque CANAL = 8 etapas
CH1  submentoniano
CH2  platisma
CH3  labio inferior
CH4  laringe
RLD (9o electrodo, clavicula)
integrador inversor; sensa el punto medio de RG de los 4 canales (604k c/u)
RLDMODE 2 = RLD activo (RLIM 390k) | 1 = sin RLD: ref. pasiva a VREF por 390k (RPAS) | 0 = ref. directa
SIMULACION
Correr (Run) y graficar ADC1..ADC4. 0.5 s tarda ~3 min. CASE=2: senoidal 100x menor; CASE=0: sin ruido.
.include opa.lib
.include models/ina_behav.lib
.include afe_channel.lib
.param CASE=1
.param RATIO={if(CASE==2,100,10)} KN={if(CASE==0,0,1)}
.param NLF=1m NWH=300u NTOT={sqrt(NLF**2+NWH**2)} AS={NTOT*sqrt(2)/RATIO}
.param F1=73 F2=131 F3=211 F4=307
.func stim(f,a,b) {AS*sin(2*pi*f*time)+KN*(NLF*a+NWH*b)}
.param RLDMODE=2 CINT=1n RLIM=390k RS=100k CCM=47p CD=100p
.param CMB=3p RIMB=51k RER=20k
.param CGE=1 VMAINS_TRAN={if(CASE==0,0,311)} VMAINS_AC=0
.tran 0 0.5 0 50u
.param RLIM_EF={if(RLDMODE==2,RLIM,1T)} RPAS_EF={if(RLDMODE==2,1T,if(RLDMODE==1,RLIM,1))}
.options gmin=100f plotwinsize=0
