roadtothewest/SSI/sim/ltspice/AUDIT_RLD.asc

CA: cap; 10u
CBE: cap; 200p
CGE: cap; {CGE}
CI1: cap; 47n
CI2: cap; 47n
CI3: cap; 47n
CI4: cap; 47n
CINT: cap; {CINT}
CMB: cap; {CMB}
RA1: res; 100k
RA2: res; 100k
RGE: res; 1G
RI1: res; {RIMB}
RI2: res; {RIMB}
RI3: res; {RIMB}
RI4: res; {RIMB}
RLIM: res; {RLIM_EF}
RPAR: res; 10Meg
RPAS: res; {RPAS_EF}
RSM1: res; 604k
RSM2: res; 604k
RSM3: res; 604k
RSM4: res; 604k
VCC: voltage; 3.3
VIN1: voltage; 0
VIN2: voltage; 0
VIN3: voltage; 0
VIN4: voltage; 0
VM: voltage; SINE(0 {VMAINS_TRAN} 50) AC {VMAINS_AC}
XCH1: CANAL
XCH2: CANAL
XCH3: CANAL
XCH4: CANAL
XE1N: ELECTRODO; ELECTRODE; Vhc=-5m
XE1P: ELECTRODO; ELECTRODE; Vhc=5m
XE2N: ELECTRODO; ELECTRODE; Vhc=0
XE2P: ELECTRODO; ELECTRODE; Vhc=12m
XE3N: ELECTRODO; ELECTRODE; Vhc=10m
XE3P: ELECTRODO; ELECTRODE; Vhc=-8m
XE4N: ELECTRODO; ELECTRODE; Vhc=-15m
XE4P: ELECTRODO; ELECTRODE; Vhc=3m
XER: ELECTRODO; ELECTRODE; Vhc=0 Re={RER}
XRLD: opamp2; OPA
XVR: opamp2; OPA
Named nets: VCC, 0, VREF, MAINS, EARTH, BODY, n1, EP1, EN1, ADC1, RGM1, INA1, n2, EP2, EN2, ADC2, RGM2, INA2, n3, EP3, EN3, ADC3, RGM3, INA3, n4, EP4, EN4, ADC4, RGM4, INA4, RLDO
AuraVox - AFE sEMG: 4 canales diferenciales, 9 electrodos (4 pares + RLD), 4 salidas ADC1..ADC4
Auditoria RLD: red de 311 Vpk por el cuerpo, sin senal, comparacion SIN RLD (paso 1) vs CON RLD (paso 2)
Flujo: ESTIMULO -> ELECTRODOS -> CANAL (x4) -> ADC.  Doble clic en un bloque CANAL (o clic derecho > Open Hierarchy) para ver sus 8 etapas.
ALIMENTACION 3.3 V Y VREF 1.65 V
divisor 2 x 100k + 10u, seguidor MCP6004
CUERPO Y RED 50 Hz
CMB red-cuerpo, CBE cuerpo-tierra, CGE circuito-tierra (20p bateria, 1 = USB a PC)
ESTIMULO POR CANAL
diferencial, entre el cuerpo y el electrodo +
ELECTRODOS (8 de senal)
20k||47n; el - de cada par + 51k||47n
AFE: 4 CANALES
bloque CANAL = 8 etapas
CH1  submentoniano
CH2  platisma
CH3  labio inferior
CH4  laringe
RLD (9o electrodo, clavicula)
integrador inversor; sensa el punto medio de RG de los 4 canales (604k c/u)
RLDMODE 2 = RLD activo (RLIM 390k) | 1 = sin RLD: ref. pasiva a VREF por 390k (RPAS) | 0 = ref. directa
SIMULACION
Run, luego graficar ADC1..ADC4: el paso 1 (sin RLD, referencia pasiva 390k) muestra 50 Hz; el paso 2 (con RLD) casi nada. Resultados numericos: View > SPICE Error Log.
.include opa.lib
.include models/ina_behav.lib
.include afe_channel.lib
.step param RLDMODE list 1 2
.param CINT=1n RLIM=390k RS=100k CCM=47p CD=100p
.param CMB=3p RIMB=51k RER=20k
.param CGE=1 VMAINS_TRAN=311 VMAINS_AC=0
.tran 0 0.3 0 50u
.meas tran adc1_50Hz_Vpp PP V(adc1) FROM 0.2 TO 0.3
.meas tran adc2_50Hz_Vpp PP V(adc2) FROM 0.2 TO 0.3
.meas tran cuerpo_cm_Vpp PP V(body)-V(vref) FROM 0.2 TO 0.3
.meas tran rti1_uVpp param adc1_50Hz_Vpp/503*1e6
.param RLIM_EF={if(RLDMODE==2,RLIM,1T)} RPAS_EF={if(RLDMODE==2,1T,if(RLDMODE==1,RLIM,1))}
.options gmin=100f plotwinsize=0
