roadtothewest/SSI/sim/ltspice/AUDIT_SEMG.asc

BIN1: bv; V=V(sg1) + {KN}*V(nz1)
BIN2: bv; V=V(sg2) + {KN}*V(nz2)
BIN3: bv; V=V(sg3) + {KN}*V(nz3)
BIN4: bv; V=V(sg4) + {KN}*V(nz4)
CA: cap; 10u
CBE: cap; 200p
CGE: cap; {CGE}
CI1: cap; 47n
CI2: cap; 47n
CI3: cap; 47n
CI4: cap; 47n
CINT: cap; {CINT}
CMB: cap; {CMB}
RA1: res; 100k
RA2: res; 100k
RGE: res; 1G
RI1: res; {RIMB}
RI2: res; {RIMB}
RI3: res; {RIMB}
RI4: res; {RIMB}
RLIM: res; {RLIM_EF}
RPAR: res; 10Meg
RPAS: res; {RPAS_EF}
RSM1: res; 604k
RSM2: res; 604k
RSM3: res; 604k
RSM4: res; 604k
VCC: voltage; 3.3
VM: voltage; SINE(0 {VMAINS_TRAN} 50) AC {VMAINS_AC}
VNZ1: voltage; PWL file=noise/nz_ch1.pwl
VNZ2: voltage; PWL file=noise/nz_ch2.pwl
VNZ3: voltage; PWL file=noise/nz_ch3.pwl
VNZ4: voltage; PWL file=noise/nz_ch4.pwl
VSG1: voltage; PWL file=noise/semg_ch1.pwl
VSG2: voltage; PWL file=noise/semg_ch2.pwl
VSG3: voltage; PWL file=noise/semg_ch3.pwl
VSG4: voltage; PWL file=noise/semg_ch4.pwl
XCH1: CANAL
XCH2: CANAL
XCH3: CANAL
XCH4: CANAL
XE1N: ELECTRODO; ELECTRODE; Vhc=-5m
XE1P: ELECTRODO; ELECTRODE; Vhc=5m
XE2N: ELECTRODO; ELECTRODE; Vhc=0
XE2P: ELECTRODO; ELECTRODE; Vhc=12m
XE3N: ELECTRODO; ELECTRODE; Vhc=10m
XE3P: ELECTRODO; ELECTRODE; Vhc=-8m
XE4N: ELECTRODO; ELECTRODE; Vhc=-15m
XE4P: ELECTRODO; ELECTRODE; Vhc=3m
XER: ELECTRODO; ELECTRODE; Vhc=0 Re={RER}
XRLD: opamp2; OPA
XVR: opamp2; OPA
Named nets: VCC, 0, VREF, MAINS, EARTH, BODY, sg1, nz1, n1, EP1, EN1, ADC1, RGM1, INA1, sg2, nz2, n2, EP2, EN2, ADC2, RGM2, INA2, sg3, nz3, n3, EP3, EN3, ADC3, RGM3, INA3, sg4, nz4, n4, EP4, EN4, ADC4, RGM4, INA4, RLDO
AuraVox - AFE sEMG: 4 canales diferenciales, 9 electrodos (4 pares + RLD), 4 salidas ADC1..ADC4
Auditoria sEMG: senal mioelectrica (CH1 submentoniano, CH2 platisma, CH3 labio, CH4 laringe) + ruido mayor (movimiento, ECG, red, blanco)
Flujo: ESTIMULO -> ELECTRODOS -> CANAL (x4) -> ADC.  Doble clic en un bloque CANAL (o clic derecho > Open Hierarchy) para ver sus 8 etapas.
ALIMENTACION 3.3 V Y VREF 1.65 V
divisor 2 x 100k + 10u, seguidor MCP6004
CUERPO Y RED 50 Hz
CMB red-cuerpo, CBE cuerpo-tierra, CGE circuito-tierra (20p bateria, 1 = USB a PC)
ESTIMULO POR CANAL
diferencial, entre el cuerpo y el electrodo +
ELECTRODOS (8 de senal)
20k||47n; el - de cada par + 51k||47n
AFE: 4 CANALES
bloque CANAL = 8 etapas
CH1  submentoniano
CH2  platisma
CH3  labio inferior
CH4  laringe
RLD (9o electrodo, clavicula)
integrador inversor; sensa el punto medio de RG de los 4 canales (604k c/u)
RLDMODE 2 = RLD activo (RLIM 390k) | 1 = sin RLD: ref. pasiva a VREF por 390k (RPAS) | 0 = ref. directa
SIMULACION
Run (~12 min) y comparar V(sg1) (sEMG limpio) con V(adc1) y V(n1)-V(body) (entrada con ruido). KN=0 quita el ruido; RLDMODE=1 quita el RLD.
.include opa.lib
.include models/ina_behav.lib
.include afe_channel.lib
.param KN=1
.param RLDMODE=2 CINT=1n RLIM=390k RS=100k CCM=47p CD=100p
.param CMB=3p RIMB=51k RER=20k
.param CGE=1 VMAINS_TRAN=311 VMAINS_AC=0
.tran 0 2 0 50u
.param RLIM_EF={if(RLDMODE==2,RLIM,1T)} RPAS_EF={if(RLDMODE==2,1T,if(RLDMODE==1,RLIM,1))}
.options gmin=100f plotwinsize=0
