roadtothewest/SSI/(commit log)

2026-07-30 Se crea carpeta donde se guardarán las datasheet de componentes (IIS3DWB)
2026-07-31 bom v0
2026-09-18 Pivot AFE a sEMG discreto de 3 canales + confirmar micrófono digital
    - README: pipeline y roadmap actualizados de acelerómetro (IIS3DWB) a AFE
    sEMG de 3 canales; micrófono INMP441 confirmado como digital I2S.
    - bom.csv: componentes del acelerómetro marcados como costo hundido;
    INMP441 marcado validado; agregado BOM cotizado del AFE discreto
    (~USD 30-54, dentro del tope de USD 60), descartando 4x BioAmp EXG Pill
    (~USD 138) y HackEEG (USD 495-2090, descontinuado) por presupuesto.
    - docs/afe-emg/AFE_EMG_Diseno.md: nota de decisión sobre la ruta descartada
    y advertencia de posible falsificación de INA333 en AliExpress.
    - docs/refactor-emg-software.md (nuevo): metodología de caus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
2026-09-18 Corregir estado del mic, reabrir AFE a 4 canales, agregar HMI multi-pestaña y verificación WORLD
    - README/bom/docs: el INMP441 NO está comprado todavía (era un error de la
    sesión anterior); se deja como candidato recomendado con evidencia de
    audio real, pendiente de confirmar antes de comprar.
    - AFE reabierto a 4 canales (submentoniano, platisma, labio inferior,
    laringe con CH4 dedicado), restaurando la tabla original de 9 electrodos.
    Se reevaluó HackEEG/ADS129x: técnicamente superior pero descartado por
    no-disponibilidad (descontinuado, TQFP-64 sin breakout comercial, baja
    disponibilidad en Chile), no por mérito técnico - queda como ruta de v2.
    - refactor-emg-software.m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
2026-09-19 Agregar traspaso para Gemini: contexto y diseño del AFE sEMG
    Dos documentos con la transcripción por tema de la conversación de
    diseño del AFE: decisiones y contexto del proyecto, y detalle técnico del
    circuito con correcciones y puntos abiertos.
2026-09-26 Subir todo el contenido local y traspaso maestro para simular el AFE en PLECS
    Agrega los archivos que estaban sin trackear (KiCad del acelerómetro,
    papers, notas de sprint, round-trip de audio), BioAmp-EXG-Pill como
    submódulo, los PDFs AD8232 y AuraVox, y CONTEXTO_CLAUDE.md con el estado
    completo, valores de partida, hallazgos nuevos y plan de simulación.
    Corrige en bom.csv la nota del LDO (3.0 V) y el conteo de op-amps, y
    actualiza el diagrama del AFE al orden acordado.
    Claude-Session: https://claude.ai/code/session_01QxGbzr4svhqqnaGP7fsjDf
2026-09-27 AFE sEMG: valores de componentes, BoM y simulación LTspice
    Agrega docs/afe-emg/AFE_valores_ltspice.md (INA333 + 6x MCP6004, valores
    por bloque de la pizarra, verificación del diseño de Gemini, resultados)
    y sim/ltspice/ con netlists T2 (AC), T4 (50 Hz modo común, sensado RLD)
    y T4b (filtro RFI). Actualiza bom.csv y agrega datasheets INA333/MCP6004.
    Claude-Session: https://claude.ai/code/session_01V5Cz1Wb6HSRhqzouEW9mso
2026-09-27 Eliminar la propuesta del acelerómetro; testbed y herramientas a sEMG
    - Firmware: se quita el driver IIS3DWB (iis3dwb.c/.h, SPI1, GPIO, lazo
    ACC) de main.c, frame.c/.h, main.h, usb_cdc.h y Makefile. Queda un
    comentario donde va la captura EMG 4 canales (frame 0x03).
    - Go (ssr-ingest, ssr-inspect, ssr-replay): tipo ACC reemplazado por EMG
    (0x03). inspect y replay compilan.
    - export.py: lee frames EMG (4 x int16, --fs-emg) y calcula la CWT de
    los 4 canales; probado con un .ssr sintético.
    - Borrados: Accel/ (KiCad), Accel_Connections.png, datasheet y footprint
    del IIS3DWB, hardware/flex-pcb, hardware-plan.md, executive-summary.tex,
    resumen.pdf y el diagrama de montaje mecánico.
    -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
2026-09-27 AFE sEMG: banco LTspice de 4 canales, esquemáticos y resultados
    - Banco completo: 4 canales diferenciales, 9 electrodos (4 pares + RLD),
    4 salidas ADC, modelo de cuerpo y red; estímulo propio por canal.
    - Esquemáticos jerárquicos AFE_4CH.asc + CANAL.asc generados por
    tools/make_asc.py y verificados contra los netlists (check_asc.py).
    - Pruebas: T2 respuesta y diafonía, T4 50 Hz / sensado RLD, T4b filtro
    RFI, T5 RLD en frecuencia (Cint), T6 RLD con/sin en el tiempo, T7
    senoidal 10x y 100x menor que el ruido en los 4 canales.
    - INA333 equivalente (models/ina_behav.lib) para transitorios largos,
    validado contra el macromodelo TI (G, BW, CMRR dentro de 0,1 dB).
    - tools/: lector de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
2026-09-30 AFE LTspice: esquemáticos por etapas y hojas de auditoría (RLD, sEMG)
    - CANAL.asc: 8 etapas en recuadros numerados, señal cableada.
    - AFE_4CH.asc ordenado por bloques; AUDIT_RLD.asc y AUDIT_SEMG.asc.
    - t8_rld_robustez.cir (24 condiciones), gen_semg.py, audit_figs.py.
    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
2026-10-02 BoM modular del AFE en xlsx (por módulo, con requisitos de ICs y tiendas)
    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
2026-10-02 AFE LTspice: hoja única AuraVox_AFE.asc lista para Run
    - Estímulos nativos de LTspice (white + Laplace, PULSE, ECG PWL REPEAT), sin Python.
    - Un Run = sin RLD / con RLD; .meas de modo común, SNR de salida y rango en el pin del ADC.
    - Modelo de la entrada Arduino A1..A4 del STM32N6570-DK (UM3300).
    - Valores E24 editables y BoM en la hoja; BoM xlsx con ICs elegidos + versión compacta.
    - check_asc.py detecta pines y redes abiertas.
    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
2026-10-02 AFE: trimmer de 25k en G2 por canal (ganancia por sitio); notas del módulo INA333
    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
2026-10-03 AFE: 3 canales (submentoniano, labio, laringe) con TS922 y LPF MFB+SK
    - Canal de 7 etapas: HPF SK + LPF MFB x25 + LPF SK (4o orden), sin G2 ni buffer.
    - 11 secciones de op-amp = 6 TS922 (stock en Chile). Modelo TS922 conductual.
    - Hoja AuraVox_AFE.asc de 3 canales; BoM xlsx actualizada.
    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
2026-10-03 AFE: alimentación 5 V USB -> TLV75733P, nombres reales (TS922, 1N4148), BoM con adaptadores, conectores de electrodos y micrófono
    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
2026-10-03 AFE: TS922 con el macromodelo oficial de ST (TS92X); opción de pseudo-transitorio
    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
2026-10-03 LDO: modelo conductual estable (el anterior oscilaba y dejaba VCC en ~25 mV)
    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
2026-10-04 AFE: ganancia x2500 (MFB x125), Cm0 de bloqueo DC, RLD siempre conectado, estimulo RLC
    - MFB: RM1 2.4k, RM2 300k, RM3 2.2k, CM1 150n, CM2 1n (f0 506 Hz, Q 0.545) + Cm0 10u
    - RLD: integrador -> RLIM 390k -> electrodo; sin .step ni modos (sin RLD = borrar el cable)
    - pasabanda del estimulo sEMG como RLC serie en vez de Laplace
    - medidas: VCC, VREF, DC y pico de cada ADC, rafaga/reposo solo AC
    - BoM y README actualizados
    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
2026-10-04 BoM: adaptadores SOP8/TSSOP8 doble cara, Cm0 ceramico o bipolar, aviso del terminal del cable de electrodo
    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
2026-10-04 BoM: carritos del 4-oct (Global + MechatronicStore) cargados por fila, faltantes y avisos
    - columnas Parte en el carrito y Cant. en carrito; estado En carrito/Pendiente
    - S08D8 en vez de adaptador doble cara, TLV757 dead bug, conector hembra 2x8 + bus Dupont
    - fila nueva: 1 uF ceramico a la salida del LDO
    - Resumen: subtotal por tienda, lista de faltantes y avisos
    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
2026-10-04 BoM: Cm1 (100n+47n poliester), C21 15n poliester y 1 uF MLCC del LDO, por agregar en Global
    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
2026-10-04 BoM: carrito actualizado (tiras de header, Cm1 100n+47n, 1 uF MLCC), C21 = 10n + 4.7n (15n agotado), lista FALTA COMPRAR al final
    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
2026-10-04 BoM: C21 y tiras Dupont en carrito; perfboard e insumos ya disponibles; falta solo electrodos, cables y alcohol
    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
2026-10-04 BoM: pedidos Global y MechatronicStore comprados; Dupont sueltos (faltan 12 M-H, 6 M-M); armado de Cm1 = 100n||47n y C21 = 10n||4.7n
    - esquematico con los valores armados (CM1 147n, C21 14.7n) y notas de armado en los recuadros
    - README: seccion Armado
    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
2026-10-06 docs: plan de actividades hasta el 15-oct (AFE, cables apantallados, FW, Go/HMI, WORLD)
    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
2026-10-07 papers: ubicacion de electrodos sEMG (Hwang 2026, Gaddy 2020, Le 2026, Sensors 2025) + resumen para 3 canales y vocales
    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
2026-10-09 firmware: protocolo SPI DK -> Raspberry (tuplas, bloque, DRDY) para el N6
    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
2026-10-09 chore(n6): add CubeMX base project, spec v0.3 and plan 1 for the capture firmware
    FSBL + ThreadX project for the STM32N6570-DK generated by the CubeMX CLI from
    the NUCLEO-N657X0-Q Tx_Thread_Creation .ioc. HAL/CMSIS and ThreadX copies are
    git-ignored and regenerated with scripts/mx_generate_ssi_capture.txt.
    Spec v0.3 adopts ssr-testbed/firmware/PROTOCOLO_SPI.md as the link format.
2026-10-09 feat(n6): ssi_capture base with NC region, logger, LEDs and test tools
    MPU region 0 moved to 0x341F8000 (32 KB, NOLOAD .noncacheable), own linker
    script, ADC/SAI/SPI HAL modules enabled from CMake, App/ modules log, led,
    mon and app hooked in USER CODE blocks. tools/: fw.sh (build, load to RAM),
    run_test.sh and uart_log.py (VCP checks; drains stale VCP bytes and times
    from the boot banner). P1 in RAM passes on the DK.
2026-10-09 feat(n6): PROTOCOLO_SPI block builder, audio decode and window pairing with host tests
    avx_block builds the 538-byte SPI block of ssr-testbed/firmware/PROTOCOLO_SPI.md
    (20 tuples, CRC-16/CCITT-FALSE, voice = 24-bit sample >> 8); tools/avx_block.py
    parses it the way the RPi5 does. acq_logic pairs the EMG and audio DMA windows
    and adds an integer sqrt for the audio RMS. Host tests run with ASan/UBSan.
2026-10-09 feat(n6): INMP441 capture on SAI2-B with an exact 16 kHz audio clock
    mic_sai: HSE (crystal mode, verified on the DK) -> PLL4 1179.648 MHz -> IC7
    49.152 MHz -> MCKDIV 12 -> FS 16 kHz; SAI2 block B master RX, Philips I2S,
    24-bit data in 32-bit slots; circular GPDMA linked list over two 10 ms windows
    in non-cacheable memory. mon v2 probes the last window once per second.
    On the DK without a microphone: sai_ck = 49152000, 100 windows/s, no errors.
2026-10-09 feat(n6): FS-locked 2 kHz EMG (TIM1 ETR) with a bench LPTIM trigger, ADC1 scan and DMA
    sync: TIM1 counts the SAI FS on ETR (D6->D2 bridge), ARR 7, counter preset so
    EMG sample i lands at mid-frame 8i (c = 0). Bench build (cmake
    -DSSI_SYNC_LPTIM=ON, tools/fw.sh honours SSI_SYNC_LPTIM) triggers the ADC from
    LPTIM1 clocked by CLKP = HSE, the audio crystal, so the EMG chain runs without
    the bridge. emg_adc: ADC1 3-channel scan (INP10/16/8), 246.5-cycle sampling,
    <= 50 MHz kernel clock, circular GPDMA. capture fixes the start order.
    On the DK: bench build emgblk == audblk at 100 windows/s, no errors; default
    build without the bridge correctly converts nothing.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
2026-10-09 feat(n6): acq pipeline building PROTOCOLO_SPI blocks, SWD diagnostics and restart fix
    acq pairs the EMG and audio windows and builds one 538-byte block per 10 ms
    (seq = window number, ts = 10000*seq + 500*i, bit0/bit1 for ADC/SAI loss),
    sink checks blocks like the RPi5 does, diag keeps a 1 s capture for SWD,
    testpulse drives D7 for the sync test, mon prints STAT/SIG and runs SWD
    mailbox commands. tools: swd.py, diag.py, restart_test.sh.
    Fix: STM32CubeN6 v1.4.1 HAL_ADC_Stop_DMA clears CFGR1.DMNGT and
    HAL_ADC_Start_DMA never restores it, so every capture restart left the EMG
    converting without DMA. emg_adc_start restores the circular mode.
    On the DK (bench build, no wires): 6400 blocks in 65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
2026-10-09 fix(n6): restart the capture on driver errors; add stall and DMA fault injection tests
    Final review of plan 1. A SAI or ADC/DMA error used to leave the stream
    stopped forever (spec §7 wants stop + restart): acq now restarts both
    streams together on any new driver error and re-baselines the counters.
    Verified by suspending the SAI and the ADC GPDMA channels over SWD (real
    overruns): the capture comes back with a new epoch, one seq skipped and
    one block flagged.
    Also exercises the late-consumer path on hardware: mon command 7 blocks
    acq for 30 ms; the overwritten windows are counted as lost, their seq is
    skipped and the next block carries bit0, with no CRC errors.
    tools/restart_test.sh becom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
2026-10-10 feat(n6): SPI link state machine of PROTOCOLO_SPI §4 with host tests; plan 2
    link_logic decides, per event (new block, transfer complete, CS rising),
    which actions the SPI driver runs: arm and raise DRDY, replace an unread
    block with a fresh DRDY edge, never cut a transfer in progress (drop the
    new block), and re-arm from byte 0 when CS rises early. Pure C, tested
    on the host. docs/: plan 2 (link, watchdog, flash boot, README).
2026-10-10 feat(n6): SPI5 slave link with DRDY replacing the provisional sink
    link: SPI5 slave TX-only with GPDMA (normal mode), hardware NSS on PA3 with
    its rising edge on EXTI3 (pin kept in its SPI alternate function), DRDY on
    PH5, driven by link_logic. acq wakes the link through an event flag after
    queueing each block; mon prints the link counters and gets command 9
    (bench: pull the unwired NSS low then high). The block sample for SWD now
    lives in link (s_link_sample).
    On the DK without a master: 100 blocks armed per second, each unread one
    replaced with a fresh DRDY edge (repl = arm - 1), no SPI or DMA errors; an
    NSS low pulse drops the 2 blocks that arrive and the rising edge aborts
    and re-arms o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
2026-10-10 feat(n6): IWDG supervised by mon (acq and link liveness)
    mon starts the IWDG (LSI/64, reload 500: ~1 s) once acq and link run their
    loops and refreshes it only while both keep looping, so a hung thread (or
    mon itself) resets the MCU. Boot logs the reset cause from RCC_RSR and
    clears it. mon command 8 hangs acq for 2 s; on the DK the IWDG reset
    follows (RSR.IWDGRSTF) and a 65 s run with the watchdog has no reset.
    tools/swd.py gains read32.
2026-10-10 feat(n6): flash.sh to sign and program the external flash; steady green LED when idle
    tools/flash.sh builds the demo (ETR) firmware, signs it as an FSBL and
    writes it to 0x70000000 with verify (same commands as the n6_smoke flash
    test). Programmed and verified on the DK; the boot test needs BOOT0 =
    BOOT1 = L. mon sets the green LED steady while idle (spec §5) so a board
    booted from flash without the D6->D2 bridge still shows a sign of life.
2026-10-10 feat(n6): link checker for the RPi5 side with host-tested block accounting
    tools/rpi_spi_check.py runs on the Raspberry Pi with python3-spidev: it
    polls 538-byte reads (DRDY-less mode, safe now that the firmware holds a
    block arriving during a read), classifies each one with avx_block.parse
    and reports blocks/s, CRC errors, seq gaps, duplicates, flagged blocks and
    timestamp errors, so P5 does not depend on auravoxd. BlockStats is tested
    on the host with blocks derived from the C-built sample.
2026-10-10 docs(n6): record autonomous boot from external flash (R6)
    Verified with BOOT0 = BOOT1 = L after an NRST reset: boot banner, IDLE
    every 2 s, steady green LED, running code identical to the flashed image.
2026-10-10 fix(n6): P3 tone search ignores drift below 50 Hz
    diag.py audio picked the strongest bin from ~2 Hz up, so slow drift in a
    real INMP441 capture outweighed the test tone and P3 failed with the tone
    present. The audio search now starts at 50 Hz (INMP441 passband: 60 Hz);
    the EMG path keeps the full band. Host test diag_py covers both.
2026-10-11 feat(n6): microphone check with a known sound and a PC reference
    tools/mic_tone_check.sh plays five tones (250 Hz..4 kHz) on the PC while
    the DK captures audio over SWD, and records the PC microphone as a
    reference so a silent speaker cannot pass for a deaf microphone.
    tools/tone_lines.py generates the signal and measures each tone (host test
    tone_lines_py). On 2026-10-10 it showed the first INMP441 module is deaf:
    the reference hears the tones at +18..+63 dB, the INMP441 stays under +9 dB.
    README records the result and the pending P3 with a new module.
2026-10-12 auravoxd: servicio Go de la Raspberry (SPI + HMI web + CWT + causalidad), auravox_frame.h, alimentacion LDO, datasheets
    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
2026-10-12 feat(n6): decimation filter for the analog ADMP401 microphone (plan 3)
    audio_fir turns 12-bit ADC codes at 64 kHz into 16 kHz audio in the
    INMP441's 24-bit scale: 97-tap linear-phase FIR (Kaiser, cut-off 8 kHz,
    flat to 6.5 kHz, >= 75 dB from 9.5 kHz, Q30 with exact unity DC gain,
    generated by tools/gen_audio_fir.py), decimation by 4 and a 2.5 Hz DC
    blocker, both primed with the first sample. Fixed latency: 12 outputs
    (0.75 ms). Host test audio_fir checks gain, alias rejection, DC removal,
    block continuity, latency and saturation. Plan 3 documents the design.
2026-10-12 refactor(n6): common microphone interface and shared HSE start
    mic.h is the audio source seen by acq, capture and mon: windows of 160
    samples at 16 kHz in the 24-bit scale, copied then decoded. mic_sai.c
    implements it for the INMP441 (unchanged behaviour: left-slot extraction,
    right-slot activity, SCK pin control) and compiles only when
    SSI_MIC_SRC == SSI_MIC_I2S. hse.c owns the idempotent HSE start used by
    the SAI audio clock and by the LPTIM sync backend. INIT now reports
    mic= and mic_ck= instead of sai_ck=. Both I2S builds (ETR, LPTIM) compile
    without warnings.
2026-10-12 feat(n6): ADMP401 analog microphone on A3, sampled by ADC2 at 64 kHz
    mic_adc.c implements mic.h for the SparkFun ADMP401 breakout: ADC2
    channel 13 (PA12, A3), 12 bits, 246.5 cycles like the EMG, triggered by
    LPTIM2 at 64 kHz, circular word DMA on GPDMA1 channel 3 with its own
    callbacks (the ADC HAL callbacks and ADC1_2 IRQ stay with emg_adc), and
    audio_fir to 16 kHz. sync starts LPTIM1 (EMG, 2 kHz) and LPTIM2 together
    from the HSE, both comparing at 375, so EMG sample i and ADC2 sample 32i
    (audio sample 8i) are taken together. capture inits ADC2 after ADC1 and
    arms both ADCs before the LPTIMs. CMake option SSI_MIC_ANALOG (default
    ON); SSI_MIC_ANALOG=OFF builds the INMP441 as before. All thre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
2026-10-12 feat(n6): P4 sync test for the analog microphone (diag.py pulse --analog)
    With the ADMP401 the D7 pulse reaches the audio through ADC2 and the
    decimation filter, so the edge is smoothed and delayed. The analog mode
    takes the audio edge at the middle of the step (level just before it,
    step size from A1, which has the same divider and buffer): the FIR is
    symmetric, so the expected c is its latency, 12 frames (sync 0 + FIR 12).
    test_diag simulates the whole analog chain with the real coefficients:
    c = 12 when aligned, 20 when the EMG is sampled 32 ADC2 samples late.
2026-10-12 docs(n6): README for the ADMP401 microphone (plan 3)
    Wiring (AUD on A3, VCC from IOREF and its own GND, INMP441 as option),
    voice scale and DC removal, fixed latency of the decimation filter
    (750 us), build variants, INIT fields (mic=, mic_ck=), analog P4 and
    status: firmware ready and host-tested, board test pending.
2026-10-12 docs(n6): power the ADMP401 from the 3V3 pin
    VCC goes to 3V3 (CN8-4), the pin meant to supply power; IOREF (same
    VDD3V3 net) only as a second pin once the AFE uses CN8-4.
2026-10-12 test(n6): ADMP401 passes P3 on the DK
    Stream: INIT sync=1 mic=1, 115 s without losses or errors, EMG and audio
    window counts equal. tools/mic_tone_check.sh: PASS, the five tones at
    +37..+62 dB over the noise (1 kHz measured at 999.98 Hz). The check now
    names the DK microphone instead of the INMP441.
2026-10-12 test(n6): ADMP401 passes P4 on the DK (c = 12 in 10 restarts)
    diag.py pulse --analog with D7 on A1 and A3: c = 12 audio frames
    (750 us = sync 0 + decimation filter 12) in all 10 restarts, about 100
    pulses each, d spanning one EMG period (5..12). The EMG-audio offset is
    fixed by design; the RPi5 subtracts 750 us from the audio.
2026-10-13 wip(n6): SPI link ends a read by byte count, not by CS (P5 not passing yet)
    P5 with the RPi5 showed the Pi 5 SPI (RP1, DesignWare) releases CS between
    bytes in mode 0 and when its FIFO runs dry. The link no longer aborts on a
    CS rise during a read: EOT ends it, a stalled partial read is replaced by
    the next block, SPI errors re-arm only with CS high (link_on_error), and
    EXTI3 is enabled only while a block is held. Debug counters added.
    Host tests 9/9. On the DK in mode 0 P5 still fails (underruns, 0x80);
    mode 1 with the previous logic reached 85 blocks/s. Next: mode 1 with this
    logic, or GPIO chip select on the Pi.
2026-10-13 feat(n6): rpi_spi_diag.py classifies bad SPI reads on the RPi5
    Reads like rpi_spi_check.py, keeps every read and uses the block's own
    timestamps (t0 = 10000 * seq, ts_i = t0 + 500 * i) to tell why a block
    is bad: zero tail (underrun), byte slip, a second header (block restarted
    mid-read) or bit errors. --raw saves every read for offline analysis.
2026-10-13 fix(n6): SPI5 slave ignores the CS pin, P5 passes with the RPi5
    Bad blocks arrived with bits slipped (-5..+2) from a random point on:
    the Pi 5 drives CE0 as a GPIO held low for the whole read, but the DK
    sees spurious edges on the CS line (about 1.7 M in 600 s in mode 0) and
    hardware NSS deselected the slave mid-byte on each one. With software
    NSS a read ends by its 538-byte count and CS is only read as a GPIO to
    arm blocks. Mode 0 is kept, so PROTOCOLO_SPI.md and auravoxd are
    unchanged.
    P5: rpi_spi_check.py 600 s in mode 0 at 4 MHz: 60002 blocks, 100/s,
    crc 0, gaps 0 (60 s also passes in mode 1). auravoxd with DRDY:
    100 blocks/s, no CRC errors, gaps or duplicates. Host tests 9/9.
    Co-Autho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
2026-10-13 docs+auravoxd: pines del EMG en A1/A4/A5, ADMP401 en A3, GDK 0.5437, DRDY en D4, NSS por software; auravoxd resta el retardo de la voz (-voz-delay 0.75); README al dia
    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
2026-10-13 feat(auravoxd): play recorded sessions from the HMI
    The demo can show a session recorded beforehand in good conditions
    instead of the live signal, switching from the HMI at any time.
    - source.Mux: the live source (SPI + DRDY) keeps running; a session
    player starts and stops on demand; only the active source reaches the
    decoder (a generation counter drops blocks of the previous source).
    - POST /api/source {"file": "X.avx"} plays a session in a loop at real
    time, {"file": ""} goes back live; GET /api/source and the SSE stream
    report the state. Invalid names -> 400, missing sessions -> 404.
    - The session's condition marks (.json) are applied at their blocks;
    going back live restores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
2026-10-14 docs: archive obsolete docs and legacy testbed, add docs index
    Move 4-channel/MCP6004 design docs, handoff notes, the H723 testbed
    (docs, bom, dataset, hardware, scripts, firmware/Core, ssr-* tools),
    LLM answers and loose root files to archivo/ with an index. Add
    docs/README.md mapping each topic to its current document, move
    auravox_frame.h next to PROTOCOLO_SPI.md, add the avxcwt offline
    analysis tool and update the root README map.
2026-10-15 feat(avxcwt): per-channel gain, settle time and per-condition summary
    -gain/-gains set the gain up to the Arduino pin per channel (2500 for the
    AuraVox AFE, 200 for a MyoWare 2.0 RAW output). Windows are tagged with
    the condition from the session .json and summarized per condition,
    skipping the first -settle seconds after each change. Saturated samples
    are counted per channel.
2026-10-15 fix(auravoxd): deploy-ml-lib reuses the downloaded wheels
    The AuraVox network has no internet, so deploying must not download
    the wheels again; make ml-lib refreshes them.
2026-10-15 feat(auravoxd): show or hide the model panel in Senales
    A button next to the speaking indicator toggles the classifier panel;
    each browser remembers the choice.
